Khoapham2004/DOG_ROBOT/README.md

# DOG_ROBOT
First, this project focuses on the research and development of a quadruped robot (Dog Robot). Our team used the mechanical design of the open-source DINGO Quadruped Robot as a reference. The electronic hardware, PCB design, overall kinematics, control algorithms, and software source code were entirely designed and implemented by our team.

This GitHub repository includes the complete project source code, including the Raspberry Pi software, image processing module, robot control commands, firmware for the custom PCB, the software developed to operate the robot, and the complete electrical schematic of the system.







GENERAL 
