Khoapham2004/DOG_ROBOT/PCB_Quadrupped/PCB_Quadrupped.step

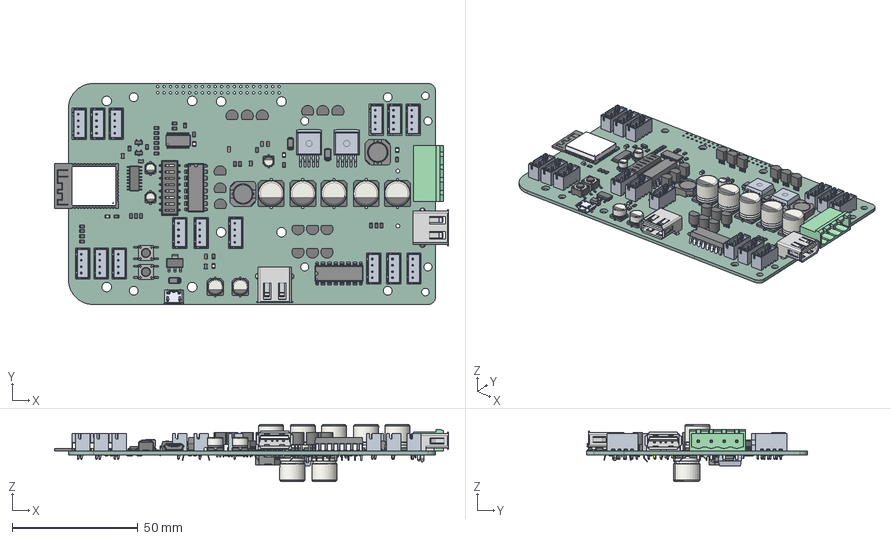
[picture p1: CAD file, 2026-07-23]
PCB_Quadrupped/PCB_Quadrupped.step
156.7 x 88.0 x 22.7 mm
R_0805_2012Metric x 78
CP_Elec_6.3x5.4 x 2
SS54-HF x 4
hoang 1.5 x 15
LED_0805_2012Metric x 6
TO-92_Inline x 15
SOT-23 x 2
C_0805_2012Metric x 8
SW_DIP_SPSTx08_Slide_6.7x21.88mm_W7.62mm_P2.54mm_LowProfile
CP_Elec_10x10.5 x 7
PCA9685PW,118
CP_Elec_4x4.5 x 3
SOIC-16_3.9x9.9mm_P1.27mm
USB-A-S-TH_S x 2
USB-A-S-W-TH_B x 2
USB-A-S-TH_P x 2
SW_Push_1P1T_NO_E-Switch_TL3301NxxxxxG x 2
MCU-MCP3008-I_P_DIP16-7.62MM_ x 2
CDRH104R-100NC--3DModel-STEP-269445 x 3
ESP32-WROOM-32D
SOT-223
ZX62D-B-5P8--3DModel-STEP-56544
PhoenixContact_MSTBA_2,5_4-G-5,08_1x04_P5.08mm_Horizontal
hoang 1.78.1 x 3
hoang_PCB
