Khoapham2004/DOG_ROBOT/(list of files, drawings)

Other design files:
PCB_Quadrupped/freerouting.dsn
