Khoapham2004/DOG_ROBOT/PCB_Quadrupped/PCB_Quadrupped.kicad_pcb

## KiCad design PCB_Quadrupped/PCB_Quadrupped.kicad_pcb (2026-07-23)

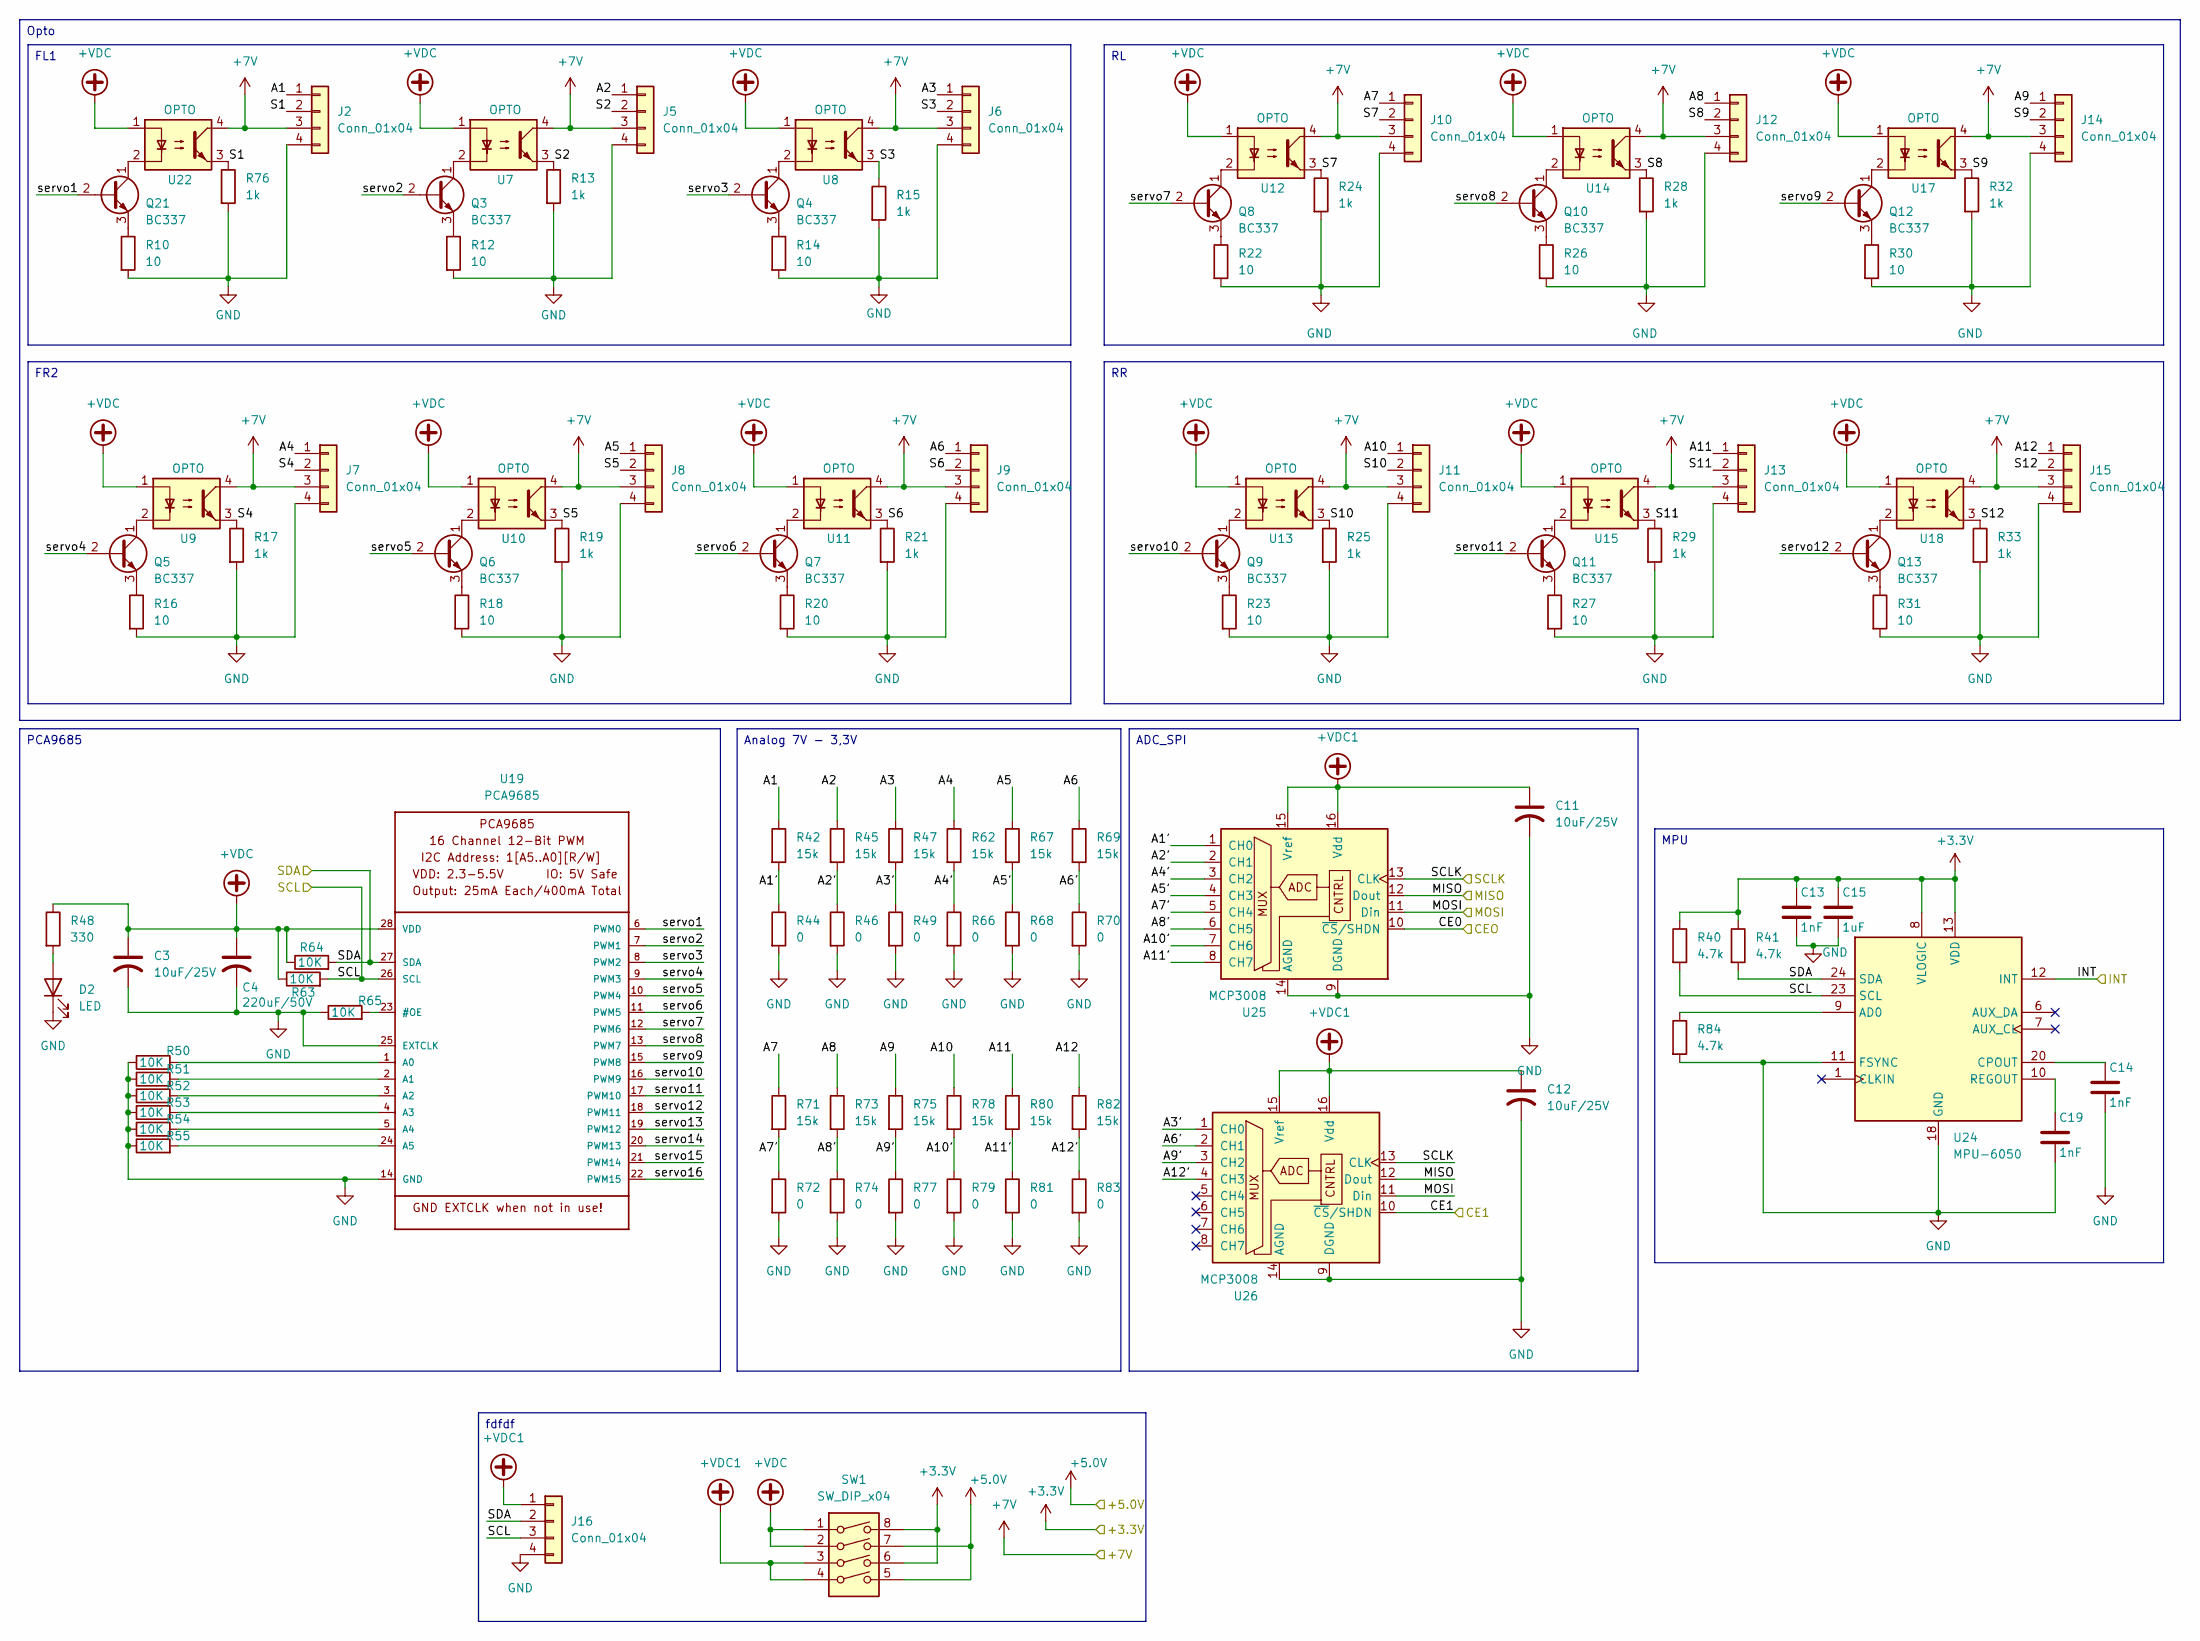
[picture p2: schematic ngoaivi.kicad_sch]

Parts:
C3, C11, C12: 10uF/25V; CP_Elec_4x4.5
C4: 220uF/50V; CP_Elec_10x10.5
C13, C14, C19: 1nF; C_0805_2012Metric
C15: 1uF; C_0805_2012Metric
D2: LED; LED_0805_2012Metric
J2, J5, J6, J7, J8, J9, J10, J11, J12, J13, J14, J15: Conn_01x04; JST_B4B-XH-A_LF__SN_
J16: Conn_01x04; PinHeader_1x04_P2.54mm_Vertical_SMD_Pin1Right
Q3, Q4, Q5, Q6, Q7, Q8, Q9, Q10, Q11, Q12, Q13, Q21: BC337; TO-92_Inline
R10, R12, R14, R16, R18, R20, R22, R23, R26, R27, R30, R31: 10; R_0805_2012Metric_Pad1.20x1.40mm_HandSolder
R13, R15, R17, R19, R21, R24, R25, R28, R29, R32, R33, R76: 1k; R_0805_2012Metric_Pad1.20x1.40mm_HandSolder
R40, R41, R84: 4.7k; R_0805_2012Metric_Pad1.20x1.40mm_HandSolder
R42, R45, R47, R62, R67, R69, R71, R73, R75, R78, R80, R82: 15k; R_0805_2012Metric_Pad1.20x1.40mm_HandSolder
R44, R46, R49, R66, R68, R70, R72, R74, R77, R79, R81, R83: 0; R_0805_2012Metric_Pad1.20x1.40mm_HandSolder
R48: 330; R_0805_2012Metric_Pad1.20x1.40mm_HandSolder
R50, R51, R52, R53, R54, R55, R63, R64, R65: 10K; R_0805_2012Metric_Pad1.20x1.40mm_HandSolder
SW1: SW_DIP_x04; SW_DIP_SPSTx04_Slide_9.78x12.34mm_W7.62mm_P2.54mm
U7, U8, U9, U10, U11, U12, U13, U14, U15, U17, U18, U22: OPTO; OptoIsolation-EL357N-G
U19: PCA9685; TSSOP28
U24: MPU-6050; InvenSense_QFN-24_4x4mm_P0.5mm
U25, U26: MCP3008; DIP16-2.54-19.2X7.62MM

Connections:
+3.3V: C13.1, C15.1, R40.1, R41.1, SW1.6, SW1.8, U24.8 (VLOGIC), U24.13 (VDD); also elsewhere on the board
+5.0V: SW1.5, SW1.7; also elsewhere on the board
+7V: J2.3, J5.3, J6.3, J7.3, J8.3, J9.3, J10.3, J11.3, J12.3, J13.3, J14.3, J15.3, U7.4, U8.4, U9.4, U10.4, U11.4, U12.4, U13.4, U14.4, U15.4, U17.4, U18.4, U22.4; also elsewhere on the board
+VDC: C3.1, C4.1, R48.1, R63.1, R64.1, SW1.1, SW1.2, U7.1, U8.1, U9.1, U10.1, U11.1, U12.1, U13.1, U14.1, U15.1, U17.1, U18.1, U19.28 (VDD), U22.1
+VDC1: C11.1, C12.1, J16.1, SW1.3, SW1.4, U25.15 (Vref), U25.16 (Vdd), U26.15 (Vref), U26.16 (Vdd)
/Ngoại vi/A1: J2.1, R42.1
/Ngoại vi/A1': R42.2, R44.1, U25.1 (CH0)
/Ngoại vi/A2: J5.1, R45.1
/Ngoại vi/A2': R45.2, R46.1, U25.2 (CH1)
/Ngoại vi/A3: J6.1, R47.1
/Ngoại vi/A3': R47.2, R49.1, U26.1 (CH0)
/Ngoại vi/A4: J7.1, R62.1
/Ngoại vi/A4': R62.2, R66.1, U25.3 (CH2)
/Ngoại vi/A5: J8.1, R67.1
/Ngoại vi/A5': R67.2, R68.1, U25.4 (CH3)
/Ngoại vi/A6: J9.1, R69.1
/Ngoại vi/A6': R69.2, R70.1, U26.2 (CH1)
/Ngoại vi/A7: J10.1, R71.1
/Ngoại vi/A7': R71.2, R72.1, U25.5 (CH4)
/Ngoại vi/A8: J12.1, R73.1
/Ngoại vi/A8': R73.2, R74.1, U25.6 (CH5)
/Ngoại vi/A9: J14.1, R75.1
/Ngoại vi/A9': R75.2, R77.1, U26.3 (CH2)
/Ngoại vi/A10: J11.1, R78.1
/Ngoại vi/A10': R78.2, R79.1, U25.7 (CH6)
/Ngoại vi/A11: J13.1, R80.1
/Ngoại vi/A11': R80.2, R81.1, U25.8 (CH7)
/Ngoại vi/A12: J15.1, R82.1
/Ngoại vi/A12': R82.2, R83.1, U26.4 (CH3)
/Ngoại vi/CE0: U25.10 (~CS/SHDN); also elsewhere on the board
/Ngoại vi/CE1: U26.10 (~CS/SHDN); also elsewhere on the board
/Ngoại vi/INT: U24.12 (INT); also elsewhere on the board
/Ngoại vi/MISO: U25.12 (Dout), U26.12 (Dout); also elsewhere on the board
/Ngoại vi/MOSI: U25.11 (Din), U26.11 (Din); also elsewhere on the board
/Ngoại vi/S1: J2.2, R76.1, U22.3
/Ngoại vi/S2: J5.2, R13.1, U7.3
/Ngoại vi/S3: J6.2, R15.1, U8.3
/Ngoại vi/S4: J7.2, R17.1, U9.3
/Ngoại vi/S5: J8.2, R19.1, U10.3
/Ngoại vi/S6: J9.2, R21.1, U11.3
/Ngoại vi/S7: J10.2, R24.1, U12.3
/Ngoại vi/S8: J12.2, R28.1, U14.3
/Ngoại vi/S9: J14.2, R32.1, U17.3
/Ngoại vi/S10: J11.2, R25.1, U13.3
/Ngoại vi/S11: J13.2, R29.1, U15.3
/Ngoại vi/S12: J15.2, R33.1, U18.3
/Ngoại vi/SCL: J16.3, R40.2, R63.2, U19.26 (SCL), U24.23 (SCL); also elsewhere on the board
/Ngoại vi/SCLK: U25.13 (CLK), U26.13 (CLK); also elsewhere on the board
/Ngoại vi/SDA: J16.2, R41.2, R64.2, U19.27 (SDA), U24.24 (SDA); also elsewhere on the board
/Ngoại vi/servo1: Q21.2 (B), U19.6 (PWM0)
/Ngoại vi/servo2: Q3.2 (B), U19.7 (PWM1)
/Ngoại vi/servo3: Q4.2 (B), U19.8 (PWM2)
/Ngoại vi/servo4: Q5.2 (B), U19.9 (PWM3)
/Ngoại vi/servo5: Q6.2 (B), U19.10 (PWM4)
/Ngoại vi/servo6: Q7.2 (B), U19.11 (PWM5)
/Ngoại vi/servo7: Q8.2 (B), U19.12 (PWM6)
/Ngoại vi/servo8: Q10.2 (B), U19.13 (PWM7)
/Ngoại vi/servo9: Q12.2 (B), U19.15 (PWM8)
/Ngoại vi/servo10: Q9.2 (B), U19.16 (PWM9)
/Ngoại vi/servo11: Q11.2 (B), U19.17 (PWM10)
/Ngoại vi/servo12: Q13.2 (B), U19.18 (PWM11)
/Ngoại vi/servo13: U19.19 (PWM12)
/Ngoại vi/servo14: U19.20 (PWM13)
/Ngoại vi/servo15: U19.21 (PWM14)
/Ngoại vi/servo16: U19.22 (PWM15)
GND: C3.2, C4.2, C11.2, C12.2, C13.2, C14.2, C15.2, C19.2, D2.1 (K), J2.4, J5.4, J6.4, J7.4, J8.4, J9.4, J10.4, J11.4, J12.4, J13.4, J14.4, J15.4, J16.4, R10.2, R12.2, R13.2, R14.2, R15.2, R16.2, R17.2, R18.2, R19.2, R20.2, R21.2, R22.2, R23.2, R24.2, R25.2, R26.2, R27.2, R28.2, R29.2, R30.2, R31.2, R32.2, R33.2, R44.2, R46.2, R49.2, R50.1, R51.1, R52.1, R53.1, R54.1, R55.1, R65.1, R66.2, R68.2, R70.2, R72.2, R74.2, R76.2, R77.2, R79.2, R81.2, R83.2, R84.2, U19.14 (GND), U19.25 (EXTCLK), U24.11 (FSYNC), U24.18 (GND), U25.9 (DGND), U25.14 (AGND), U26.9 (DGND), U26.14 (AGND); also elsewhere on the board
unnamed: D2.2 (A), R48.2
unnamed: Q3.1 (C), U7.2
unnamed: Q3.3 (E), R12.1
unnamed: Q4.1 (C), U8.2
unnamed: Q4.3 (E), R14.1
unnamed: Q5.1 (C), U9.2
unnamed: Q5.3 (E), R16.1
unnamed: Q6.1 (C), U10.2
unnamed: Q6.3 (E), R18.1
unnamed: Q7.1 (C), U11.2
unnamed: Q7.3 (E), R20.1
unnamed: Q8.1 (C), U12.2
unnamed: Q8.3 (E), R22.1
unnamed: Q9.1 (C), U13.2
unnamed: Q9.3 (E), R23.1
unnamed: Q10.1 (C), U14.2
unnamed: Q10.3 (E), R26.1
unnamed: Q11.1 (C), U15.2
unnamed: Q11.3 (E), R27.1
unnamed: Q12.1 (C), U17.2
unnamed: Q12.3 (E), R30.1
unnamed: Q13.1 (C), U18.2
unnamed: Q13.3 (E), R31.1
unnamed: Q21.1 (C), U22.2
unnamed: Q21.3 (E), R10.1
unnamed: R65.2, U19.23 (#OE)
unnamed: R50.2, U19.1 (A0)
unnamed: R51.2, U19.2 (A1)
unnamed: R52.2, U19.3 (A2)
unnamed: R53.2, U19.4 (A3)
unnamed: R54.2, U19.5 (A4)
unnamed: R55.2, U19.24 (A5)
unnamed: R84.1, U24.9 (AD0)
unnamed: C14.1, U24.20 (CPOUT)
unnamed: C19.1, U24.10 (REGOUT)

Notes on the sheet:
ADC_SPI
PCA9685
Opto
fdfdf
FR2
MPU
Analog 7V - 3,3V
FL1

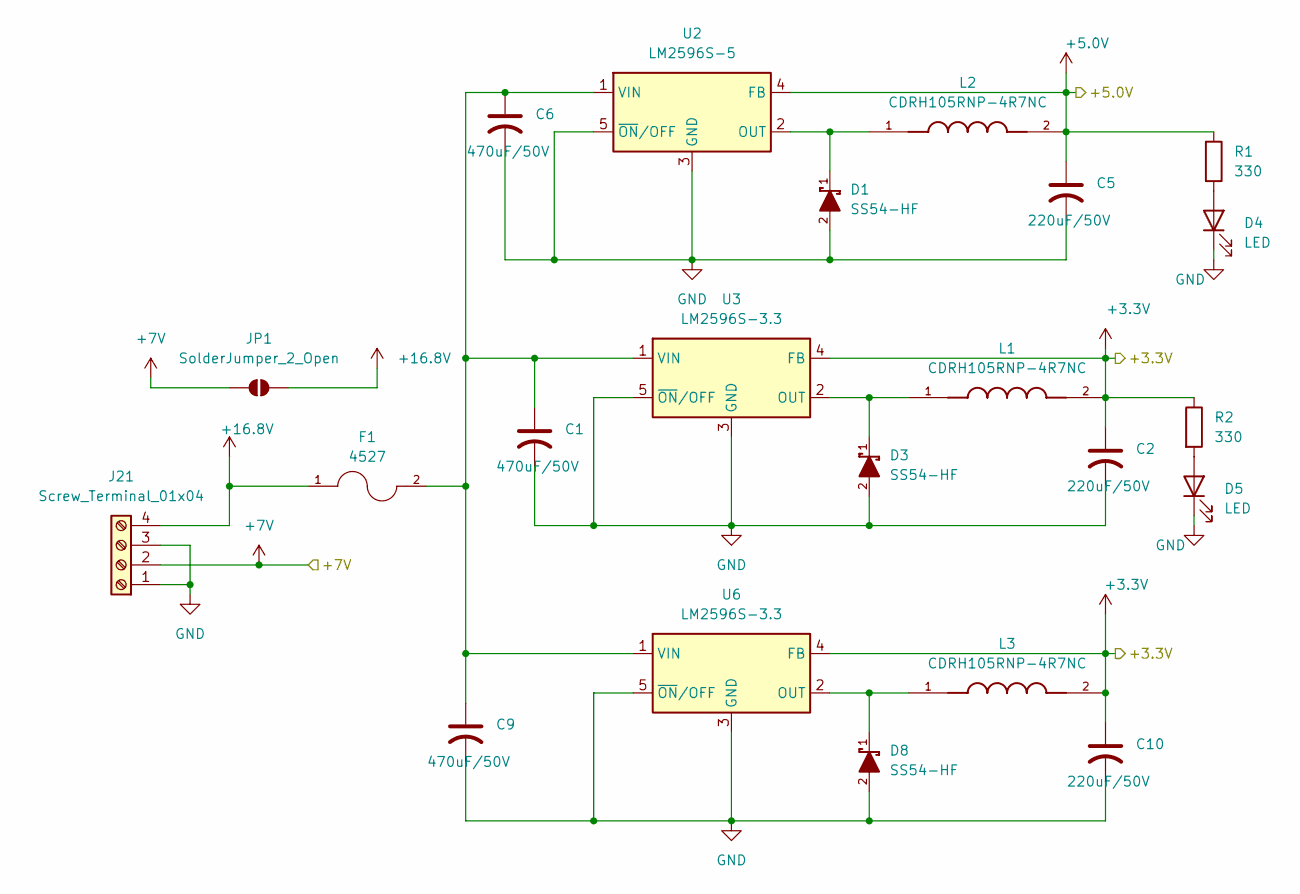
[picture p3: schematic Power.kicad_sch]

Parts:
C1, C6, C9: 470uF/50V; CP_Elec_10x10.5
C2, C5, C10: 220uF/50V; CP_Elec_10x10.5
D1, D3, D8: SS54-HF; DIOM5025X220N; MOUSER_PART_NUMBER 750-SS54-HF
D4, D5: LED; LED_0805_2012Metric
F1: 4527; FUSE_4527
J21: Screw_Terminal_01x04; PhoenixContact_MSTBA_2,5_4-G-5,08_1x04_P5.08mm_Horizontal
JP1: SolderJumper_2_Open; SolderJumper-2_P1.3mm_Open_RoundedPad1.0x1.5mm
L1, L2, L3: CDRH105RNP-4R7NC; IND_CDRH105RNP-4R7NC; PARTREV 23-Oct-2017
R1, R2: 330; R_0805_2012Metric_Pad1.20x1.40mm_HandSolder
U2: LM2596S-5; TO-263-5_TabPin3
U3, U6: LM2596S-3.3; TO-263-5_TabPin3

Connections:
+3.3V: C2.1, C10.1, L1.2, L3.2, R2.1, U3.4 (FB), U6.4 (FB); also elsewhere on the board
+5.0V: C5.1, L2.2, R1.1, U2.4 (FB); also elsewhere on the board
+7V: J21.2, JP1.1 (A); also elsewhere on the board
+16.8V: F1.1, J21.4, JP1.2 (B)
GND: C1.2, C2.2, C5.2, C6.2, C9.2, C10.2, D1.2, D3.2, D4.1 (K), D5.1 (K), D8.2, J21.1, J21.3, U2.3 (GND), U2.5 (~ON/OFF), U3.3 (GND), U3.5 (~ON/OFF), U6.3 (GND), U6.5 (~ON/OFF); also elsewhere on the board
unnamed: D4.2 (A), R1.2
unnamed: D5.2 (A), R2.2
unnamed: D1.1, L2.1, U2.2 (OUT)
unnamed: C1.1, C6.1, C9.1, F1.2, U2.1 (VIN), U3.1 (VIN), U6.1 (VIN)
unnamed: D3.1, L1.1, U3.2 (OUT)
unnamed: D8.1, L3.1, U6.2 (OUT)

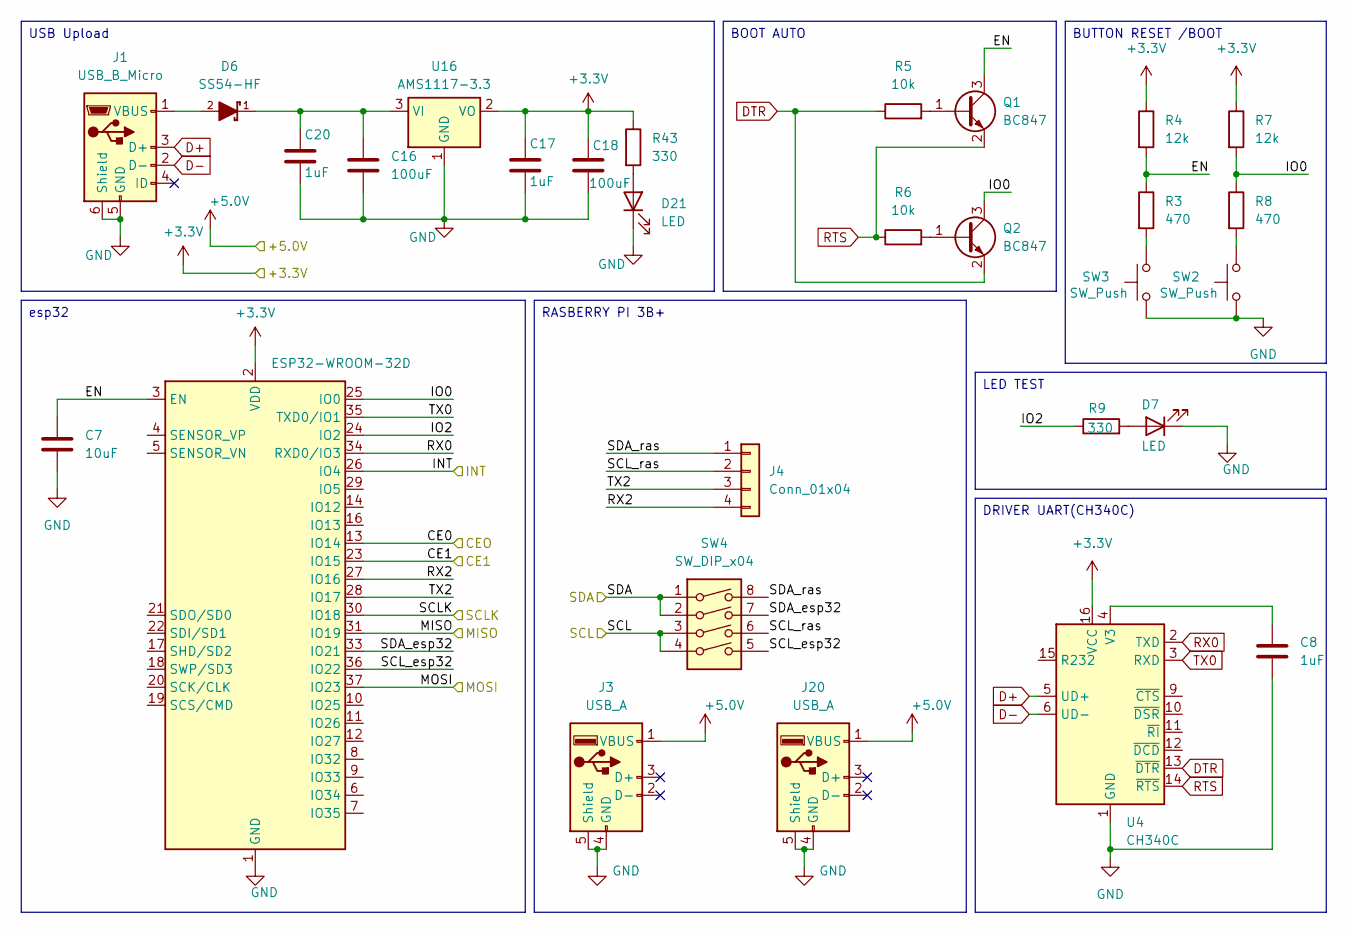
[picture p4: schematic vidieukhien.kicad_sch, Microcontroller]

Parts:
C7: 10uF; C_0805_2012Metric_Pad1.18x1.45mm_HandSolder
C8, C17, C20: 1uF; C_0805_2012Metric_Pad1.18x1.45mm_HandSolder
C16, C18: 100uF; CP_Elec_6.3x5.4
D6: SS54-HF; DIOM5025X220N; MOUSER_PART_NUMBER 750-SS54-HF
D7, D21: LED; LED_0805_2012Metric
J1: USB_B_Micro; USB_Micro-B_Molex-105017-0001
J3: USB_A; USB_A_Stewart_SS-52100-001_Horizontal
J4: Conn_01x04; JST_B4B-XH-A_LF__SN_
J20: USB_A; USB_A_Kycon_KUSBX-AS1N-B_Horizontal
Q1, Q2: BC847; SOT-23
R3, R8: 470; R_0805_2012Metric_Pad1.20x1.40mm_HandSolder
R4, R7: 12k; R_0805_2012Metric_Pad1.20x1.40mm_HandSolder
R5, R6: 10k; R_0805_2012Metric_Pad1.20x1.40mm_HandSolder
R9, R43: 330; R_0805_2012Metric_Pad1.20x1.40mm_HandSolder
SW2, SW3: SW_Push; SW_Push_1P1T_NO_E-Switch_TL3301NxxxxxG
SW4: SW_DIP_x04; SW_DIP_SPSTx04_Slide_9.78x12.34mm_W7.62mm_P2.54mm
U1: ESP32-WROOM-32D
U4: CH340C; SOIC-16_3.9x9.9mm_P1.27mm
U16: AMS1117-3.3; SOT-223-3_TabPin2

Connections:
+3.3V: C17.1, C18.1, R4.1, R7.1, R43.1, U1.2 (VDD), U4.16 (VCC), U16.2 (VO); also elsewhere on the board
+5.0V: J3.1 (VBUS), J20.1 (VBUS); also elsewhere on the board
/Ngoại vi/CE0: U1.13 (IO14); also elsewhere on the board
/Ngoại vi/CE1: U1.23 (IO15); also elsewhere on the board
/Ngoại vi/INT: U1.26 (IO4); also elsewhere on the board
/Ngoại vi/MISO: U1.31 (IO19); also elsewhere on the board
/Ngoại vi/MOSI: U1.37 (IO23); also elsewhere on the board
/Ngoại vi/SCL: SW4.3, SW4.4; also elsewhere on the board
/Ngoại vi/SCLK: U1.30 (IO18); also elsewhere on the board
/Ngoại vi/SDA: SW4.1, SW4.2; also elsewhere on the board
/microcontroler/EN: C7.1, Q1.3 (C), R3.1, R4.2, U1.3 (EN)
/microcontroler/IO0: Q2.3 (C), R7.2, R8.1, U1.25 (IO0)
/microcontroler/IO2: R9.1, U1.24 (IO2)
/microcontroler/RX2: J4.4, U1.27 (IO16)
/microcontroler/SCL_esp32: SW4.5, U1.36 (IO22)
/microcontroler/SCL_ras: J4.2, SW4.6
/microcontroler/SDA_esp32: SW4.7, U1.33 (IO21)
/microcontroler/SDA_ras: J4.1, SW4.8
/microcontroler/TX2: J4.3, U1.28 (IO17)
D+: J1.3 (D+), U4.5 (UD+)
D-: J1.2 (D-), U4.6 (UD-)
DTR: Q2.2 (E), R5.1, U4.13 (~DTR)
GND: C7.2, C8.2, C16.2, C17.2, C18.2, C20.2, D7.1 (K), D21.1 (K), J1.5 (GND), J1.6 (Shield), J3.4 (GND), J3.5 (Shield), J20.4 (GND), J20.5 (Shield), SW2.1, SW3.1, U1.1 (GND), U1.15 (GND), U1.38 (GND), U1.39 (GND), U4.1 (GND), U16.1 (GND); also elsewhere on the board
unnamed: D7.2 (A), R9.2
unnamed: D21.2 (A), R43.2
unnamed: D6.2, J1.1 (VBUS)
unnamed: Q1.1 (B), R5.2
unnamed: Q2.1 (B), R6.2
unnamed: R3.2, SW3.2
unnamed: R8.2, SW2.2
unnamed: C8.1, U4.4 (V3)
unnamed: C16.1, C20.1, D6.1, U16.3 (VI)
RTS: Q1.2 (E), R6.1, U4.14 (~RTS)
RX0: U1.34 (RXD0/IO3), U4.2 (TXD)
TX0: U1.35 (TXD0/IO1), U4.3 (RXD)

Notes on the sheet:
BUTTON RESET /BOOT
DRIVER UART(CH340C)
esp32
RASBERRY PI 3B+
LED TEST
USB Upload
BOOT AUTO

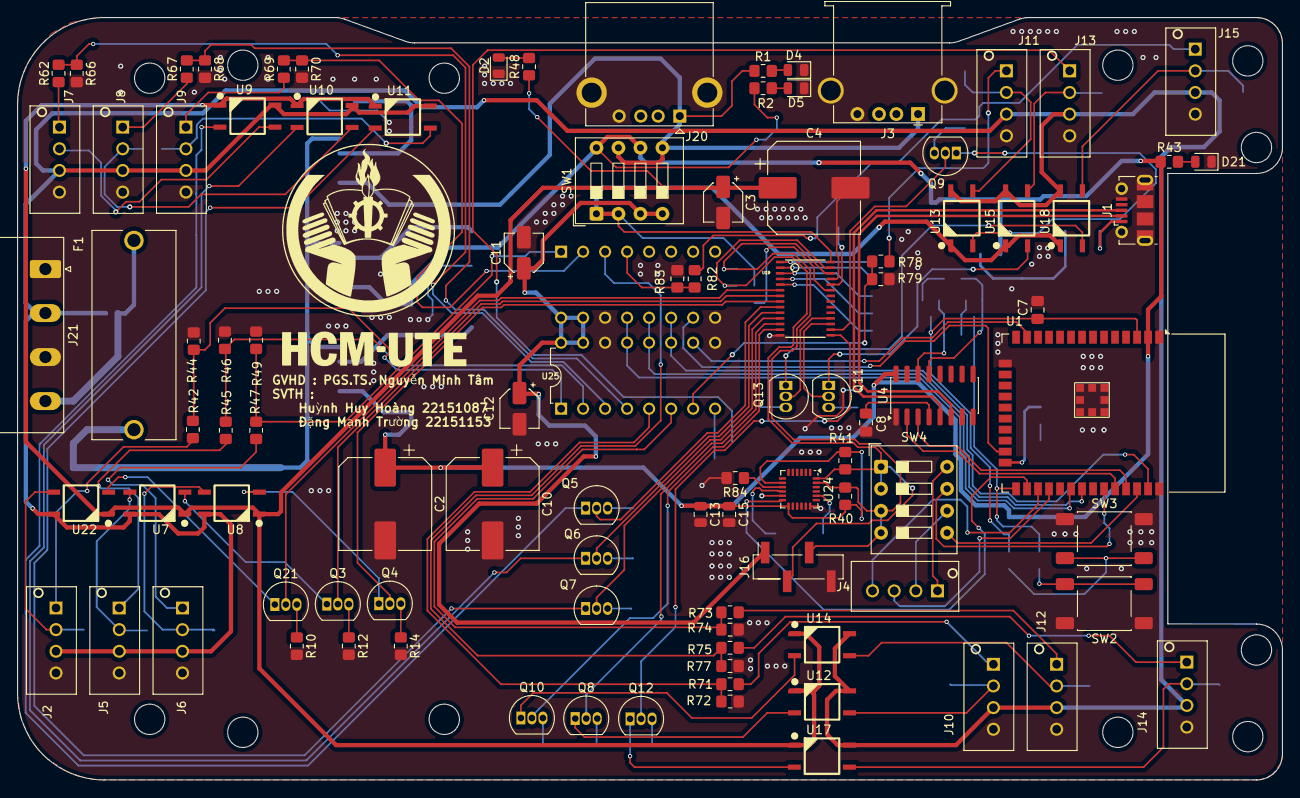
[picture p5: board PCB_Quadrupped.kicad_pcb from above]

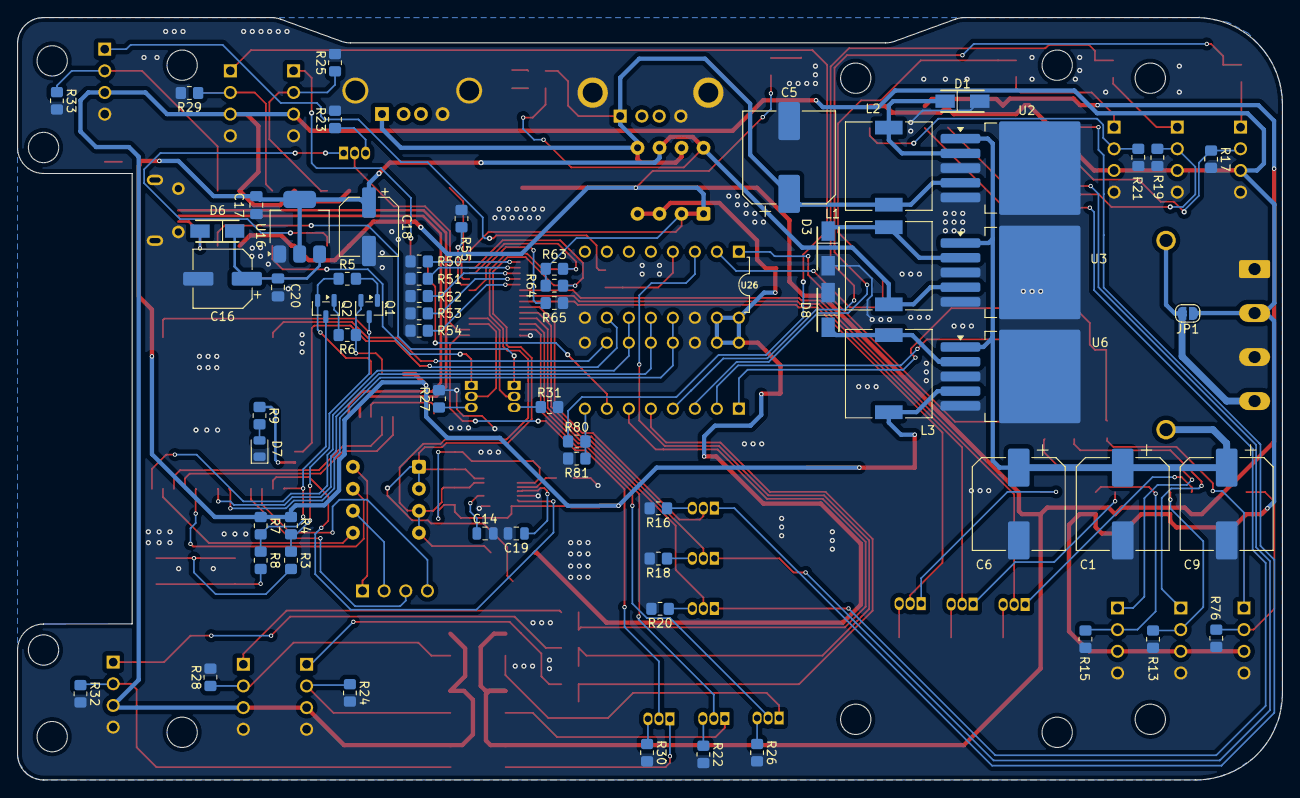
[picture p6: board PCB_Quadrupped.kicad_pcb from below]

Board: 2 copper layers, 146.0 x 88.0 mm, 163 parts (65 on the bottom side), 128 nets.
