Khoapham2004/DOG_ROBOT/CODE/GUI.py

#!/usr/bin/env python3

import time
import socket
import struct
import threading
import json
import os
import math
import csv
from datetime import datetime
from collections import deque
from typing import List, Optional, Tuple

import tkinter as tk
from tkinter import ttk, messagebox, filedialog

import cv2
import numpy as np

from PIL import Image, ImageTk

import matplotlib
matplotlib.use("TkAgg")
from matplotlib.backends.backend_tkagg import FigureCanvasTkAgg
from matplotlib.figure import Figure

import mediapipe as mp

# ============================================================
# Thứ tự gửi setpoint SBAL
# ============================================================
# Quy ước joystick: ngang trái/phải điều chỉnh Roll, dọc lên/xuống điều chỉnh Pitch.
# ESP đang nhận lệnh SET_SBAL_SP theo thứ tự Pitch trước, Roll sau,
# vì vậy GUI gửi theo thứ tự PITCH_ROLL để trục dọc điều khiển đúng Pitch.
SBAL_SP_SEND_ORDER = "PITCH_ROLL"

# ============================================================
# ROS 2 tùy chọn - publish góc khớp sang Gazebo
# ============================================================
ROS_OK = False
ROS_ERR = ""
try:
    import rclpy
    from rclpy.node import Node
    from rclpy.qos import QoSProfile, ReliabilityPolicy, HistoryPolicy
    from trajectory_msgs.msg import JointTrajectory, JointTrajectoryPoint
    from sensor_msgs.msg import Imu
    from builtin_interfaces.msg import Duration
    ROS_OK = True
except Exception as e:
    ROS_ERR = str(e)
    rclpy = None
    Node = object
    Imu = object


# ============================================================
# Camera từ Raspberry
# ============================================================
UDP_IP = "0.0.0.0"
CAMERA_UDP_PORT = 5005

# ============================================================
# Offset từ GUI gửi về Raspberry
# ============================================================
RASPBERRY_IP = "192.168.0.107"
RASPBERRY_OFFSET_PORT = 6006

# ============================================================
# Điều chỉnh chiều cao: GUI gửi trực tiếp X+ / X- xuống ESP thông qua Raspberry.
# ESP bản mới xử lý X+ / X- để thay đổi trục X cho các pose/gait FWD, BWD, LEFT, RIGHT, STOP, SL và SR.
# ============================================================
HEIGHT_DEFAULT_X = -190.0
HEIGHT_STEP_X = 10.0
HEIGHT_MIN_X = -230.0
HEIGHT_MAX_X = -150.0

# ============================================================
# Thông số gait mặc định
# GUI gửi thông số xuống ESP qua Raspberry bằng lệnh:
#   SET_GAIT MODE hStep tCycle phase swingRatio
# Ý nghĩa tham số trong ESP:
#   hStep      : độ nhấc chân theo trục X trong pha vung.
#   tCycle     : thời gian hoàn thành một chu kỳ bước, đơn vị giây.
#   phase      : độ lệch pha giữa hai nhóm chân FL+RR và FR+RL, trong khoảng 0..1.
#   swingRatio : tỉ lệ thời gian chân ở pha vung, trong khoảng 0.05..0.49.
# ============================================================
GAIT_CONFIG_PATH = os.path.expanduser("~/.quadruped_gait_config.json")
GAIT_MODES = ["FWD", "BWD", "LEFT", "RIGHT", "SL", "SR"]
GAIT_DEFAULTS = {
    "FWD":   {"hStep": 100.0, "tCycle": 0.70, "phase": 0.50, "swing": 0.35},
    "BWD":   {"hStep": 100.0, "tCycle": 0.70, "phase": 0.50, "swing": 0.35},
    "LEFT":  {"hStep":  50.0, "tCycle": 0.40, "phase": 0.50, "swing": 0.35},
    "RIGHT": {"hStep":  50.0, "tCycle": 0.40, "phase": 0.50, "swing": 0.35},
    "SL":    {"hStep":  50.0, "tCycle": 0.70, "phase": 0.50, "swing": 0.35},
    "SR":    {"hStep":  50.0, "tCycle": 0.70, "phase": 0.50, "swing": 0.35},
}

# ============================================================
# Tọa độ pose mặc định - đồng bộ với pose trong code ESP.
# Mỗi pose gồm tọa độ của bốn chân: FL(x,y,z), FR(x,y,z), RL(x,y,z), RR(x,y,z).
# ============================================================
POSE_LEGS = ["FL", "FR", "RL", "RR"]
POSE_AXES = ["x", "y", "z"]
POSE_DEFAULTS = {
    "STAND": {"FL": [-190.0, -44.2, 30.0], "FR": [-190.0, 44.2, 40.0], "RL": [-190.0, -44.2, 40.0], "RR": [-190.0, 44.2, 40.0]},
    "SIT":   {"FL": [-230.0, -50.0, 40.0], "FR": [-230.0, 50.0, 40.0], "RL": [-120.0, -100.0, -10.0], "RR": [-120.0, 100.0, -10.0]},
    "LIE":   {"FL": [-80.0, -100.0, -10.0], "FR": [-80.0, 100.0, -10.0], "RL": [-80.0, -100.0, -10.0], "RR": [-80.0, 100.0, -10.0]},
    "SHAKE": {"FL": [-225.0, -55.0, 35.0], "FR": [-230.0, 0.0, 40.0], "RL": [-120.0, -100.0, -10.0], "RR": [-120.0, 100.0, -10.0]},
    "STAMP": {"FL": [-210.0, -55.0, 0.0], "FR": [-210.0, 55.0, 0.0], "RL": [-210.0, -55.0, 20.0], "RR": [-210.0, 55.0, 20.0]},
    "FWD":   {"FL": [-197.0, -55.0, 0.0], "FR": [-210.0, 55.0, 0.0], "RL": [-197.0, -55.0, 20.0], "RR": [-210.0, 55.0, 20.0]},
    "BWD":   {"FL": [-201.0, -55.0, 0.0], "FR": [-210.0, 55.0, 0.0], "RL": [-201.0, -55.0, 20.0], "RR": [-210.0, 55.0, 20.0]},
    "LEFT":  {"FL": [-210.0, 0.0, 0.0], "FR": [-210.0, 100.0, 0.0], "RL": [-210.0, 0.0, 20.0], "RR": [-210.0, 100.0, 20.0]},
    "RIGHT": {"FL": [-210.0, -100.0, 0.0], "FR": [-210.0, 0.0, 0.0], "RL": [-210.0, -100.0, 20.0], "RR": [-210.0, 0.0, 20.0]},
    "SIDE":  {"FL": [-202.0, -55.0, 0.0], "FR": [-210.0, 55.0, 0.0], "RL": [-202.0, -55.0, 20.0], "RR": [-210.0, 55.0, 20.0]},
}
POSE_CONFIG_PATH = os.path.expanduser("~/.quadruped_pose_coords.json")

# ============================================================
# GUI nhận dữ liệu IMU từ Raspberry
# ============================================================
IMU_LISTEN_IP = "0.0.0.0"
IMU_LISTEN_PORT = 7007

# ============================================================
# Camera và MediaPipe
# ============================================================
WIDTH = 640
HEIGHT = 480

GAUSS_KERNEL = (5, 5)
GAUSS_SIGMA = 0

CENTER_DEADBAND_PX = 25

MIN_DETECTION_CONF = 0.5
MIN_TRACKING_CONF = 0.5
FULL_BODY_VISIBILITY_TH = 0.45

SEND_INTERVAL = 0.05
LPF_ALPHA = 0.85

BOX_H_LIMIT = 360

# ============================================================
# Giảm offset theo bề rộng khung người
# ============================================================
# Khi box_width_lpf <= OFFSET_SCALE_REF_BOX_W, offset gửi xuống bridge được giữ nguyên.
# Khi box_width_lpf lớn hơn giá trị tham chiếu, offset_send = offset_lpf * (REF / box_width_lpf).
# OFFSET_SCALE_MIN_RATIO giới hạn mức giảm nhỏ nhất để offset không bị thu nhỏ về 0.
# Ví dụ với REF=260, box_width_lpf=520 và min_ratio=0.25:
#   scale = max(260/520, 0.25) = 0.50, nghĩa là offset gửi đi còn 50%.
OFFSET_SCALE_BY_BOX_W_ENABLE = 1
OFFSET_SCALE_REF_BOX_W = 260
OFFSET_SCALE_MIN_RATIO = 0.25

# Lệnh từ GUI gửi về Pi, sau đó Pi chuyển tiếp xuống ESP.
AUTO_STAND_BEFORE_FWD = False

SEND_PID_SETTING_ON_START = False
CAM_PID_CMD = "SET_CAMGAIT 0.18 0.00 0.04 35 25 6 120"

SEND_STOP_SETTING_ON_START = False
CAM_STOP_CMD = "SET_CAMSTOP 360 800"

# ============================================================
# Cấu hình đồ thị
# ============================================================
PLOT_SECONDS_WINDOW = 5
PLOT_MAX_POINTS = 400

ROLL_YLIM = (-20, 20)
PITCH_YLIM = (-20, 20)
YAW_YLIM = (-180, 180)

# ============================================================
# Làm mượt đồ thị Balance theo thời gian thực
# ============================================================
# Các thông số này chỉ dùng cho đường vẽ live ở tab Balance, giúp hạn chế giật do spike hoặc rung UDP.
# Dữ liệu ghi vào file CSV vẫn là dữ liệu raw, không bị lọc.
BALANCE_PLOT_FILTER_ENABLE = 0       # Không lọc ở GUI. ESP đã lọc rồi, GUI chỉ vẽ raw mới nhất.
BALANCE_PLOT_LPF_ALPHA = 0.0         # Giữ lại để tương thích file config cũ, không dùng cho Balance plot.
BALANCE_PLOT_MAX_STEP_DEG = 999.0    # Giữ lại để tương thích file config cũ, không dùng cho Balance plot.
BALANCE_PLOT_FIXED_Y = 1             # 1 = giữ trục Y cố định -20..20 để hình không bị giật do autoscale.
BALANCE_PLOT_UPDATE_MS = 30          # Chu kỳ vẽ Balance. 30 ms tương đương khoảng 33 Hz.

# Giới hạn kích thước hiển thị camera để khung giao diện gọn hơn.
CAMERA_DISPLAY_MAX_W = 760
CAMERA_DISPLAY_MAX_H = 570

# ============================================================
# Thông tin hiển thị trên GUI
# ============================================================
UNIVERSITY_NAME = "TRƯỜNG ĐẠI HỌC CÔNG NGHỆ KỸ THUẬT TP.HCM"
PROJECT_TITLE = "ĐỀ TÀI: THIẾT KẾ, CHẾ TẠO VÀ ĐIỀU KHIỂN ROBOT 4 CHÂN"
SUPERVISOR_NAME = "GVHD: PGS.TS NGUYỄN MINH TÂM"
STUDENT_NAMES = "SVTH: ĐẶNG MẠNH TRƯỜNG - HUỲNH HUY HOÀNG"

LEFT_LOGO_FILES = [
    "logo FEEE.jpg", "logo FEEE.jpeg", "logo FEEE.png",
    "logo FEEE.JPG", "logo FEEE.JPEG", "logo FEEE.PNG"
]
RIGHT_LOGO_FILES = [
    "LOGO UTE.png", "LOGO UTE.PNG", "LOGO UTE.jpg", "LOGO UTE.jpeg",
    "HCMUTE.png", "hcmute.png"
]
UTE_LOGO_TARGET_HEIGHT = 110
FEEE_LOGO_HEIGHT_RATIO = 0.8
LOGO_TEXT_GAP_X = 28

# ============================================================
# Lưu và tải cấu hình
# ============================================================
CONFIG_PATH = os.path.expanduser("~/.cam_udp_pose_gui_config.json")
REC_DEFAULT_DIR = os.path.expanduser("~/Desktop")

MODEL_COMPLEXITY = 0
CAMERA_DISPLAY_SCALE = 0.96
PLOT_UPDATE_MS = 80

# ============================================================
# Tinh chỉnh hiệu năng và FPS, có thể thay đổi trong tab Cài đặt thông số.
# ============================================================
# 1 = xử lý MediaPipe ở mọi frame; 2/3/4 = xử lý cách frame để GUI nhẹ và mượt hơn.
CAM_PROCESS_EVERY_N = 3
# 1 = chỉ chạy MediaPipe khi bật chế độ bám người; 0 = luôn chạy MediaPipe.
CAM_MEDIAPIPE_ONLY_WHEN_PID = 1
# 1 = vẽ skeleton MediaPipe; 0 = không vẽ skeleton để giảm tải CPU.
CAM_DRAW_LANDMARKS = 0
# Chu kỳ gọi update_frame của Tkinter, đơn vị ms; giá trị nhỏ giúp mượt hơn nhưng tốn CPU hơn.
CAM_UPDATE_MS = 10
# 1 = bật publish JointTrajectory sang Gazebo; 0 = tắt mặc định để GUI nhẹ hơn.
GAZEBO_PUBLISH_ENABLE = 0

# ============================================================
# Chế độ ưu tiên Balance
# Khi chuyển sang tab Balance, GUI sẽ tạm dừng các tác vụ nặng
# như decode/hiển thị camera, publish Gazebo và vẽ plot Gazebo để giảm lag.
# Luồng IMU UDP và chức năng ghi CSV vẫn hoạt động bình thường.
# ============================================================
BALANCE_FOCUS_MODE_ENABLE = 1
BALANCE_PAUSE_CAMERA = 1
BALANCE_PAUSE_GAZEBO_PUBLISH = 1
BALANCE_PAUSE_GAZEBO_IMU_PLOT = 1
BALANCE_PAUSE_JOINT_TABLE_UI = 1


# ============================================================
# Cấu hình nhận Joint UDP và mapping sang Gazebo
# ============================================================
JOINT_UDP_LISTEN_IP = "0.0.0.0"
JOINT_UDP_LISTEN_PORT = 6001
JOINT_CONFIG_PATH = os.path.expanduser("~/.quadruped_gazebo_joint_mapper.json")
JOINT_DEFAULT_TOPIC = "/joint_trajectory_controller/joint_trajectory"
JOINT_PUBLISH_HZ_LIMIT = 10.0
JOINT_POINT_TIME_SEC = 0.02
JOINT_UI_UPDATE_MS = 50

# Topic IMU của Gazebo dùng để so sánh với IMU thực tế nhận từ Raspberry qua UDP 7007.
GAZEBO_IMU_TOPIC = "/imu"
GAZEBO_IMU_PLOT_MAX_POINTS = 500
GAZEBO_IMU_PLOT_WINDOW_SEC = 10.0
GAZEBO_IMU_PLOT_UPDATE_MS = 80


RAW_JOINT_ORDER = [
    "FL_j1", "FL_j2", "FL_j3",
    "FR_j1", "FR_j2", "FR_j3",
    "RL_j1", "RL_j2", "RL_j3",
    "RR_j1", "RR_j2", "RR_j3",
]

# Thứ tự publish được giữ giống cấu hình controller trong Gazebo:
# JFL -> JFR -> JBL -> JBR
GAZEBO_PUBLISH_ORDER = [
    "JFL1", "JFL2", "JFL3",
    "JFR1", "JFR2", "JFR3",
    "JBL1", "JBL2", "JBL3",
    "JBR1", "JBR2", "JBR3",
]

# Dữ liệu đầu vào là góc IK raw sau tính toán động học nghịch, không phải góc servo đã quy đổi.
# Các joint thật trong Gazebo gồm: JBL1..3, JBR1..3, JFL1..3 và JFR1..3.
# ESP/Raspberry gửi dữ liệu theo thứ tự FL, FR, RL, RR nên cần mapping như dưới.
# FL -> JFL, FR -> JFR, RL -> JBL, RR -> JBR.
DEFAULT_JOINT_MAPPING = [
    {"src": "FL_j1", "joint": "JFL1", "sign":  1.0, "offset_deg": 0.0, "enable": True},
    {"src": "FL_j2", "joint": "JFL2", "sign":  1.0, "offset_deg": 0.0, "enable": True},
    {"src": "FL_j3", "joint": "JFL3", "sign":  1.0, "offset_deg": 0.0, "enable": True},
    {"src": "FR_j1", "joint": "JFR1", "sign":  1.0, "offset_deg": 0.0, "enable": True},
    {"src": "FR_j2", "joint": "JFR2", "sign":  1.0, "offset_deg": 0.0, "enable": True},
    {"src": "FR_j3", "joint": "JFR3", "sign":  1.0, "offset_deg": 0.0, "enable": True},
    {"src": "RL_j1", "joint": "JBL1", "sign":  1.0, "offset_deg": 0.0, "enable": True},
    {"src": "RL_j2", "joint": "JBL2", "sign":  1.0, "offset_deg": 0.0, "enable": True},
    {"src": "RL_j3", "joint": "JBL3", "sign":  1.0, "offset_deg": 0.0, "enable": True},
    {"src": "RR_j1", "joint": "JBR1", "sign":  1.0, "offset_deg": 0.0, "enable": True},
    {"src": "RR_j2", "joint": "JBR2", "sign":  1.0, "offset_deg": 0.0, "enable": True},
    {"src": "RR_j3", "joint": "JBR3", "sign":  1.0, "offset_deg": 0.0, "enable": True},
]

mp_pose = mp.solutions.pose
mp_drawing = mp.solutions.drawing_utils
mp_styles = mp.solutions.drawing_styles


class UdpCameraReceiver:
    def __init__(self, ip="0.0.0.0", port=5005):
        self.ip = ip
        self.port = port

        self.sock = None
        self.running = False
        self.thread = None

        self.frames = {}
        self.latest_frame = None
        self.lock = threading.Lock()

        self.last_packet_time = 0.0
        self.recv_fps = 0.0
        self._fps_count = 0
        self._fps_last_time = time.time()

        # Khi vào tab Balance, có thể tạm dừng decode JPEG để giảm tải CPU.
        # Socket vẫn được đọc để tránh đầy buffer, nhưng frame sẽ được bỏ qua.
        self.paused = False

    def start(self):
        self.sock = socket.socket(socket.AF_INET, socket.SOCK_DGRAM)
        self.sock.bind((self.ip, self.port))
        self.sock.settimeout(0.1)

        self.running = True
        self.thread = threading.Thread(target=self._recv_loop, daemon=True)
        self.thread.start()

        print(f"[UDP CAM] Dang nhan camera tai {self.ip}:{self.port}")

    def stop(self):
        self.running = False
        try:
            if self.sock:
                self.sock.close()
        except Exception:
            pass

    def set_paused(self, paused: bool):
        self.paused = bool(paused)
        if self.paused:
            # Xóa các chunk/frame cũ để khi bật lại không hiển thị frame tồn đọng.
            with self.lock:
                self.frames.clear()
                self.latest_frame = None
            self.recv_fps = 0.0
            self._fps_count = 0
            self._fps_last_time = time.time()

    def get_frame(self):
        with self.lock:
            if self.latest_frame is None:
                return None
            return self.latest_frame.copy()

    def _recv_loop(self):
        while self.running:
            try:
                packet, addr = self.sock.recvfrom(65536)
            except socket.timeout:
                continue
            except OSError:
                break
            except Exception as e:
                print("[UDP CAM ERR]", e)
                continue

            if self.paused:
                # Ở chế độ ưu tiên Balance, camera được bỏ qua ngay từ mức gói UDP,
                # nhờ đó tránh ghép chunk và decode JPEG gây lag GUI.
                continue

            if len(packet) < 8:
                continue

            header = packet[:8]
            chunk = packet[8:]

            try:
                frame_id, total_chunks, chunk_id = struct.unpack("!IHH", header)
            except Exception:
                continue

            if frame_id not in self.frames:
                self.frames[frame_id] = {
                    "total": total_chunks,
                    "chunks": {}
                }

            self.frames[frame_id]["chunks"][chunk_id] = chunk

            if len(self.frames[frame_id]["chunks"]) == total_chunks:
                try:
                    data = b"".join(
                        self.frames[frame_id]["chunks"][i]
                        for i in range(total_chunks)
                    )
                except KeyError:
                    self.frames.pop(frame_id, None)
                    continue

                self.frames.pop(frame_id, None)

                jpg_array = np.frombuffer(data, dtype=np.uint8)
                frame = cv2.imdecode(jpg_array, cv2.IMREAD_COLOR)

                if frame is None:
                    continue

                with self.lock:
                    self.latest_frame = frame

                self.last_packet_time = time.time()

                self._fps_count += 1
                now = time.time()
                if now - self._fps_last_time >= 1.0:
                    self.recv_fps = self._fps_count / (now - self._fps_last_time)
                    self._fps_count = 0
                    self._fps_last_time = now

                if len(self.frames) > 40:
                    old_keys = sorted(self.frames.keys())[:-10]
                    for k in old_keys:
                        self.frames.pop(k, None)


class UdpImuReceiver:
    def __init__(self, ip="0.0.0.0", port=7007):
        self.ip = ip
        self.port = port

        self.sock = None
        self.running = False
        self.thread = None

        self.lock = threading.Lock()

        self.roll = 0.0
        self.pitch = 0.0
        self.yaw = 0.0

        self.last_packet_time = 0.0
        self.recv_count = 0
        self.recv_hz = 0.0
        self._count_t0 = time.time()
        self._count_n = 0
        self.sample_seq = 0
        self.sample_buffer = deque(maxlen=10000)  # lưu tất cả mẫu UDP nhận được để REC không bị giới hạn bởi GUI update

    def start(self):
        self.sock = socket.socket(socket.AF_INET, socket.SOCK_DGRAM)
        self.sock.bind((self.ip, self.port))
        self.sock.settimeout(0.1)

        self.running = True
        self.thread = threading.Thread(target=self._recv_loop, daemon=True)
        self.thread.start()

        print(f"[UDP IMU] Dang nhan IMU tai {self.ip}:{self.port}")

    def stop(self):
        self.running = False

        try:
            if self.sock:
                self.sock.close()
        except Exception:
            pass

    def get_imu(self):
        with self.lock:
            return self.roll, self.pitch, self.yaw, self.last_packet_time

    def get_recv_hz(self):
        # Tần số thực tế GUI nhận gói IMU từ Raspberry/ESP, tính trong cửa sổ khoảng 1 giây.
        with self.lock:
            return self.recv_hz

    def get_latest_sample(self):
        # Dùng cho live plot: lấy đúng mẫu mới nhất, không lọc và không vẽ dồn buffer.
        with self.lock:
            return (
                self.sample_seq,
                self.last_packet_time,
                self.roll,
                self.pitch,
                self.yaw,
                self.recv_hz,
            )

    def get_latest_seq(self):
        with self.lock:
            return self.sample_seq

    def get_samples_since(self, last_seq):
        # Trả về toàn bộ mẫu mới GUI nhận từ Raspberry, không phụ thuộc tốc độ cập nhật giao diện.
        with self.lock:
            samples = [s for s in self.sample_buffer if s[0] > last_seq]
            latest_seq = self.sample_seq
        return samples, latest_seq

    def _recv_loop(self):
        while self.running:
            try:
                packet, addr = self.sock.recvfrom(1024)
            except socket.timeout:
                continue
            except OSError:
                break
            except Exception as e:
                print("[UDP IMU ERR]", e)
                continue

            msg = packet.decode("utf-8", errors="ignore").strip()
            parts = msg.split(",")

            if len(parts) < 3:
                continue

            try:
                roll = float(parts[0])
                pitch = float(parts[1])
                yaw = float(parts[2])
            except Exception:
                continue

            now = time.time()
            with self.lock:
                self.roll = roll
                self.pitch = pitch
                self.yaw = yaw
                self.last_packet_time = now
                self.recv_count += 1
                self._count_n += 1
                dt = now - self._count_t0
                if dt >= 1.0:
                    self.recv_hz = self._count_n / dt
                    self._count_n = 0
                    self._count_t0 = now
                self.sample_seq += 1
                self.sample_buffer.append((self.sample_seq, now, roll, pitch, yaw))


# ============================================================
# Panel mapping góc khớp sang Gazebo
# ============================================================
class GazeboJointPublisher(Node):
    def __init__(self, topic: str):
        super().__init__("quadruped_joint_mapper_gui")
        self.topic = topic

        # Controller đang subscribe ở chế độ BEST_EFFORT, nên publisher cũng dùng BEST_EFFORT để tương thích.
        try:
            qos = QoSProfile(
                history=HistoryPolicy.KEEP_LAST,
                depth=10,
                reliability=ReliabilityPolicy.BEST_EFFORT,
            )
            self.pub = self.create_publisher(JointTrajectory, topic, qos)
        except Exception:
            self.pub = self.create_publisher(JointTrajectory, topic, 10)

    def publish_positions(self, joint_names: List[str], positions_rad: List[float], point_time_sec: float):
        # Format publish giống cấu hình mẫu của Gazebo:
        # msg.joint_names = ['JFL1','JFL2','JFL3','JFR1','JFR2','JFR3','JBL1','JBL2','JBL3','JBR1','JBR2','JBR3']
        # point.positions dùng đơn vị radian và cùng thứ tự với danh sách joint.
        msg = JointTrajectory()
        msg.joint_names = list(joint_names)

        p = JointTrajectoryPoint()
        p.positions = [float(x) for x in positions_rad]
        sec = int(point_time_sec)
        p.time_from_start = Duration(
            sec=sec,
            nanosec=int((point_time_sec - sec) * 1e9),
        )
        msg.points.append(p)
        self.pub.publish(msg)


class UdpJointReceiver:
    def __init__(self, ip: str, port: int):
        self.ip = ip
        self.port = port
        self.sock = None
        self.running = False
        self.thread = None
        self.lock = threading.Lock()
        self.latest_deg = [0.0] * 12
        self.latest_order = list(RAW_JOINT_ORDER)
        self.seq = 0
        self.last_packet_time = 0.0
        self.recv_hz = 0.0
        self._count_t0 = time.time()
        self._count_n = 0

    def start(self):
        self.sock = socket.socket(socket.AF_INET, socket.SOCK_DGRAM)
        self.sock.bind((self.ip, self.port))
        self.sock.settimeout(0.1)
        self.running = True
        self.thread = threading.Thread(target=self._loop, daemon=True)
        self.thread.start()
        print(f"[JOINT UDP] Listen on {self.ip}:{self.port}")

    def stop(self):
        self.running = False
        try:
            if self.sock:
                self.sock.close()
        except Exception:
            pass

    def get_latest(self):
        with self.lock:
            return list(self.latest_deg), list(self.latest_order), self.seq, self.last_packet_time, self.recv_hz

    def _parse_packet(self, data: bytes):
        s = data.decode("utf-8", errors="ignore").strip()
        if not s:
            return None

        # Định dạng mới từ Raspberry: JSON type=ik12_deg, trường deg chứa đủ 12 góc IK raw sau tính toán.
        if s.startswith("{"):
            obj = json.loads(s)
            msg_type = str(obj.get("type", ""))
            if msg_type and msg_type not in ("ik12_deg", "joint_angles_deg"):
                return None
            deg = [float(x) for x in obj.get("deg", [])]
            if len(deg) != 12:
                return None
            order = obj.get("order", RAW_JOINT_ORDER)
            if len(order) != 12:
                order = RAW_JOINT_ORDER
            seq = int(obj.get("seq", 0))
            return deg, list(order), seq

        # Định dạng dự phòng khi gửi dạng text: IK12,<12 số>.
        upper = s.upper()
        for prefix in ("IK12", "RAWIK12", "IK12DEG", "RAW_IK12"):
            if upper.startswith(prefix):
                body = s[len(prefix):].strip(" :;,	")
                parts = body.replace(";", ",").replace(" ", ",").split(",")
                nums = []
                for p in parts:
                    p = p.strip()
                    if not p:
                        continue
                    try:
                        nums.append(float(p))
                    except Exception:
                        pass
                if len(nums) == 12:
                    return nums, list(RAW_JOINT_ORDER), 0
        return None

    def _loop(self):
        while self.running:
            try:
                data, _addr = self.sock.recvfrom(4096)
            except socket.timeout:
                continue
            except OSError:
                break
            except Exception as e:
                print("[JOINT UDP] recv error:", e)
                continue
            try:
                parsed = self._parse_packet(data)
            except Exception as e:
                print("[JOINT UDP] parse error:", e)
                continue
            if parsed is None:
                continue
            deg, order, seq = parsed
            now = time.time()
            with self.lock:
                self.latest_deg = deg
                self.latest_order = order
                self.seq = seq
                self.last_packet_time = now
                self._count_n += 1
                dt = now - self._count_t0
                if dt >= 1.0:
                    self.recv_hz = self._count_n / dt
                    self._count_n = 0
                    self._count_t0 = now


class JointMapperPanel:
    def __init__(self, parent):
        self.parent = parent
        self.mapping = [dict(x) for x in DEFAULT_JOINT_MAPPING]
        self.publish_enabled = tk.BooleanVar(value=bool(GAZEBO_PUBLISH_ENABLE))
        self.deg_to_rad_enabled = tk.BooleanVar(value=True)
        self.point_time_sec = tk.DoubleVar(value=JOINT_POINT_TIME_SEC)
        self.udp_port_var = tk.IntVar(value=JOINT_UDP_LISTEN_PORT)
        self.topic_var = tk.StringVar(value=JOINT_DEFAULT_TOPIC)
        self.receiver = None
        self.ros_node = None
        self.ros_thread = None
        self.ros_running = False
        self.ros_ready = False
        self.last_pub_time = 0.0
        self.pub_count = 0
        self.pub_hz = 0.0
        self._pub_count_t0 = time.time()
        self._pub_count_n = 0
        self.raw_deg = [0.0] * 12
        self.mapped_rad = [0.0] * 12
        self.ui_paused = False

        # Cache dữ liệu để publish liên tục cho Gazebo; việc cập nhật UDP/UI chạy riêng,
        # còn thread này giữ lệnh mới nhất và publish đều theo tần số đặt trước.
        self.pub_lock = threading.Lock()
        self.latest_joint_names = []
        self.latest_positions = []
        self.latest_seq_for_publish = -1
        self.publish_thread_running = True
        self.publish_thread = None

        self.load_config()
        self.build_ui()
        self.start_udp()
        self.start_ros()
        self.start_continuous_publish_thread()
        self.update_loop()

    def is_mapping_for_this_gazebo(self, mapping):
        wanted = {"JBL1", "JBL2", "JBL3", "JBR1", "JBR2", "JBR3", "JFL1", "JFL2", "JFL3", "JFR1", "JFR2", "JFR3"}
        try:
            joints = {str(m.get("joint", "")).strip() for m in mapping}
        except Exception:
            return False
        return wanted.issubset(joints)

    def force_default_mapping(self, save=False):
        self.mapping = [dict(x) for x in DEFAULT_JOINT_MAPPING]
        if hasattr(self, "tree"):
            self.refresh_tree_static()
        if save:
            cfg = {
                "mapping": self.mapping,
                "topic": self.topic_var.get().strip(),
                "point_time_sec": self.point_time_sec.get(),
                "deg_to_rad": self.deg_to_rad_enabled.get(),
                "publish_enabled": self.publish_enabled.get(),
                "udp_port": self.udp_port_var.get(),
            }
            try:
                with open(JOINT_CONFIG_PATH, "w", encoding="utf-8") as f:
                    json.dump(cfg, f, ensure_ascii=False, indent=2)
                print("[JOINT CONFIG] Saved default JBL/JBR/JFL/JFR mapping")
            except Exception as e:
                print("[JOINT CONFIG] save default error:", e)

    def load_config(self):
        if not os.path.exists(JOINT_CONFIG_PATH):
            self.force_default_mapping(save=False)
            return
        try:
            with open(JOINT_CONFIG_PATH, "r", encoding="utf-8") as f:
                cfg = json.load(f)
            loaded_mapping = cfg.get("mapping", self.mapping)

            # Nếu file cấu hình cũ còn các tên joint kiểu FL_hip_joint hoặc FR_thigh_joint thì bỏ qua và đặt lại mapping đúng cho Gazebo hiện tại.
            if not self.is_mapping_for_this_gazebo(loaded_mapping):
                print("[JOINT CONFIG] Old/invalid mapping detected -> reset to JBL/JBR/JFL/JFR")
                self.force_default_mapping(save=True)
            else:
                self.mapping = loaded_mapping

            self.topic_var.set(cfg.get("topic", self.topic_var.get()))
            self.point_time_sec.set(float(cfg.get("point_time_sec", self.point_time_sec.get())))
            self.deg_to_rad_enabled.set(bool(cfg.get("deg_to_rad", True)))
            self.publish_enabled.set(bool(cfg.get("publish_enabled", True)))
            self.udp_port_var.set(int(cfg.get("udp_port", JOINT_UDP_LISTEN_PORT)))
            print("[JOINT CONFIG] Loaded", JOINT_CONFIG_PATH)
        except Exception as e:
            print("[JOINT CONFIG] load error:", e)
            self.force_default_mapping(save=False)

    def save_config(self):
        self.read_mapping_from_table()
        cfg = {
            "mapping": self.mapping,
            "topic": self.topic_var.get().strip(),
            "point_time_sec": self.point_time_sec.get(),
            "deg_to_rad": self.deg_to_rad_enabled.get(),
            "publish_enabled": self.publish_enabled.get(),
            "udp_port": self.udp_port_var.get(),
        }
        try:
            with open(JOINT_CONFIG_PATH, "w", encoding="utf-8") as f:
                json.dump(cfg, f, ensure_ascii=False, indent=2)
            messagebox.showinfo("Lưu mapping", f"Đã lưu:\n{JOINT_CONFIG_PATH}")
        except Exception as e:
            messagebox.showerror("Lỗi lưu mapping", str(e))

    def build_ui(self):
        main = ttk.Frame(self.parent, style="TFrame", padding=16)
        main.pack(fill=tk.BOTH, expand=True)
        ttk.Label(main, text="MAPPING 12 GÓC CHÂN → GAZEBO", style="Title.TLabel").pack(anchor="w", pady=(0, 10))

        top = ttk.Frame(main, style="Panel.TFrame", padding=12)
        top.pack(fill=tk.X, pady=(0, 10))
        ttk.Label(top, text="UDP Port nhận 12 góc:", style="Info.TLabel").grid(row=0, column=0, sticky="w")
        ttk.Entry(top, textvariable=self.udp_port_var, width=8, font=("Consolas", 13)).grid(row=0, column=1, padx=(6, 14))
        ttk.Button(top, text="Restart UDP", style="Gray.TButton", command=self.restart_udp).grid(row=0, column=2, padx=(0, 16))
        ttk.Label(top, text="ROS Topic Gazebo:", style="Info.TLabel").grid(row=0, column=3, sticky="w")
        ttk.Entry(top, textvariable=self.topic_var, width=46, font=("Consolas", 13)).grid(row=0, column=4, padx=(6, 14))
        ttk.Button(top, text="Reconnect ROS", style="Blue.TButton", command=self.restart_ros).grid(row=0, column=5, padx=(0, 12))
        ttk.Checkbutton(top, text="Publish Gazebo", variable=self.publish_enabled).grid(row=1, column=0, sticky="w", pady=(8, 0))
        ttk.Checkbutton(top, text="deg → rad", variable=self.deg_to_rad_enabled).grid(row=1, column=1, sticky="w", pady=(8, 0))
        ttk.Label(top, text="Point time:", style="Info.TLabel").grid(row=1, column=3, sticky="w", pady=(8, 0))
        ttk.Entry(top, textvariable=self.point_time_sec, width=8, font=("Consolas", 13)).grid(row=1, column=4, sticky="w", padx=(6, 14), pady=(8, 0))
        ttk.Button(top, text="LƯU MAPPING", style="Green.TButton", command=self.save_config).grid(row=1, column=5, sticky="w", pady=(8, 0))
        ttk.Button(top, text="RESET JBL/JBR/JFL/JFR", style="Red.TButton", command=lambda: self.force_default_mapping(save=True)).grid(row=2, column=5, sticky="w", pady=(8, 0))

        self.status_label = ttk.Label(main, text="Status", style="BigImu.TLabel", padding=8)
        self.status_label.pack(fill=tk.X, pady=(0, 10))

        body = ttk.Frame(main, style="TFrame")
        body.pack(fill=tk.BOTH, expand=True)
        left = ttk.Frame(body, style="Panel.TFrame", padding=10)
        left.pack(side=tk.LEFT, fill=tk.BOTH, expand=True, padx=(0, 10))
        cols = ("src", "raw_deg", "joint", "sign", "offset", "mapped_rad", "enable")
        self.tree = ttk.Treeview(left, columns=cols, show="headings", height=15)
        headings = {"src":"Nguồn", "raw_deg":"Raw deg", "joint":"Gazebo joint name", "sign":"Sign", "offset":"Offset deg", "mapped_rad":"Mapped rad", "enable":"Enable"}
        widths = {"src":80, "raw_deg":100, "joint":260, "sign":70, "offset":105, "mapped_rad":120, "enable":80}
        for c in cols:
            self.tree.heading(c, text=headings[c])
            self.tree.column(c, width=widths[c], anchor="center")
        self.tree.pack(fill=tk.BOTH, expand=True)
        self.tree.bind("<Double-1>", self.on_tree_double_click)
        ttk.Label(left, text="Double click vào joint/sign/offset/enable để sửa. Enable nhập 1/0.", style="Info.TLabel").pack(anchor="w", pady=(8, 0))

        right = ttk.Frame(body, style="Panel.TFrame", padding=10, width=390)
        right.pack(side=tk.RIGHT, fill=tk.Y)
        right.pack_propagate(False)
        ttk.Label(right, text="Raw 12 góc từ Raspberry", style="SubTitle.TLabel").pack(anchor="w")
        self.raw_text = tk.Text(right, height=10, font=("Consolas", 12), bg="#f1f5f9")
        self.raw_text.pack(fill=tk.X, pady=(6, 12))
        ttk.Label(right, text="Mapped publish rad", style="SubTitle.TLabel").pack(anchor="w")
        self.map_text = tk.Text(right, height=10, font=("Consolas", 12), bg="#f1f5f9")
        self.map_text.pack(fill=tk.X, pady=(6, 12))
        hint = "Công thức:\n  mapped_rad = radians(raw_deg * sign + offset_deg)\n\nNếu Gazebo ngược chiều: sign = -1.\nNếu lệch zero: chỉnh offset_deg.\nTên joint phải đúng controller Gazebo."
        ttk.Label(right, text=hint, style="Info.TLabel", justify="left", wraplength=360).pack(anchor="w")
        self.refresh_tree_static()

    def refresh_tree_static(self):
        self.tree.delete(*self.tree.get_children())
        for i, m in enumerate(self.mapping):
            self.tree.insert("", "end", iid=str(i), values=(m.get("src", RAW_JOINT_ORDER[i]), "0.00", m.get("joint", ""), f"{float(m.get('sign', 1.0)):.1f}", f"{float(m.get('offset_deg', 0.0)):.2f}", "0.0000", "1" if m.get("enable", True) else "0"))

    def on_tree_double_click(self, event):
        region = self.tree.identify("region", event.x, event.y)
        if region != "cell":
            return
        row_id = self.tree.identify_row(event.y)
        col_id = self.tree.identify_column(event.x)
        if not row_id or not col_id:
            return
        col_index = int(col_id.replace("#", "")) - 1
        cols = ("src", "raw_deg", "joint", "sign", "offset", "mapped_rad", "enable")
        col = cols[col_index]
        if col not in ("joint", "sign", "offset", "enable"):
            return
        x, y, w, h = self.tree.bbox(row_id, col_id)
        old = self.tree.set(row_id, col)
        entry = ttk.Entry(self.tree)
        entry.place(x=x, y=y, width=w, height=h)
        entry.insert(0, old)
        entry.focus()
        def commit(_evt=None):
            val = entry.get().strip()
            self.tree.set(row_id, col, val)
            entry.destroy()
            self.read_mapping_from_table()
        entry.bind("<Return>", commit)
        entry.bind("<FocusOut>", commit)

    def read_mapping_from_table(self):
        new_map = []
        for i in range(12):
            vals = self.tree.item(str(i), "values")
            try:
                sign = float(vals[3])
            except Exception:
                sign = 1.0
            try:
                offset = float(vals[4])
            except Exception:
                offset = 0.0
            enable_txt = str(vals[6]).strip().lower()
            enable = enable_txt not in ("0", "false", "no", "off", "")
            new_map.append({"src": vals[0], "joint": vals[2], "sign": sign, "offset_deg": offset, "enable": enable})
        self.mapping = new_map

    def start_udp(self):
        if self.receiver:
            self.receiver.stop()
        self.receiver = UdpJointReceiver(JOINT_UDP_LISTEN_IP, int(self.udp_port_var.get()))
        self.receiver.start()

    def restart_udp(self):
        self.start_udp()

    def start_ros(self):
        if not ROS_OK:
            self.ros_ready = False
            print("[ROS] Not available:", ROS_ERR)
            return
        try:
            if not rclpy.ok():
                rclpy.init(args=None)
            self.ros_node = GazeboJointPublisher(self.topic_var.get().strip())
            self.ros_running = True
            self.ros_thread = threading.Thread(target=self._ros_spin_loop, daemon=True)
            self.ros_thread.start()
            self.ros_ready = True
            print("[ROS] Publishing to", self.topic_var.get().strip())
        except Exception as e:
            self.ros_ready = False
            print("[ROS] init error:", e)

    def restart_ros(self):
        try:
            if self.ros_node:
                self.ros_node.destroy_node()
        except Exception:
            pass
        self.ros_node = None
        self.ros_ready = False
        self.start_ros()

    def _ros_spin_loop(self):
        while self.ros_running and self.ros_node is not None:
            try:
                rclpy.spin_once(self.ros_node, timeout_sec=0.02)
            except Exception:
                time.sleep(0.05)

    def compute_mapping(self, raw_deg: List[float]):
        self.read_mapping_from_table()

        mapped_all = []
        joint_to_val = {}
        joint_enable = {}

        for i, m in enumerate(self.mapping):
            raw = raw_deg[i]
            deg = raw * float(m.get("sign", 1.0)) + float(m.get("offset_deg", 0.0))
            val = math.radians(deg) if self.deg_to_rad_enabled.get() else deg
            mapped_all.append(val)

            joint = str(m.get("joint", "")).strip()
            if joint:
                joint_to_val[joint] = val
                joint_enable[joint] = bool(m.get("enable", True))

        # Publish theo đúng thứ tự controller Gazebo yêu cầu: JFL, JFR, JBL, JBR.
        # Thứ tự publish không phụ thuộc vào thứ tự hiển thị trong bảng.
        joint_names = []
        positions = []
        for joint in GAZEBO_PUBLISH_ORDER:
            if joint_enable.get(joint, False) and joint in joint_to_val:
                joint_names.append(joint)
                positions.append(joint_to_val[joint])

        return joint_names, positions, mapped_all

    def update_publish_cache(self, joint_names: List[str], positions: List[float], seq: int):
        if not joint_names or not positions:
            return
        if len(joint_names) != len(positions):
            return
        with self.pub_lock:
            self.latest_joint_names = list(joint_names)
            self.latest_positions = [float(x) for x in positions]
            self.latest_seq_for_publish = int(seq)

    def start_continuous_publish_thread(self):
        if self.publish_thread is not None and self.publish_thread.is_alive():
            return
        self.publish_thread_running = True
        self.publish_thread = threading.Thread(target=self._continuous_publish_loop, daemon=True)
        self.publish_thread.start()

    def _continuous_publish_loop(self):
        # Publish liên tục theo cấu hình Gazebo: tần số mục tiêu và time_from_start do GUI thiết lập.
        # Không phụ thuộc tốc độ refresh GUI, giúp Gazebo nhận lệnh đều hơn khi robot di chuyển.
        next_t = time.time()
        while self.publish_thread_running:
            hz = max(1.0, float(JOINT_PUBLISH_HZ_LIMIT))
            period = 1.0 / hz
            next_t += period

            if self.publish_enabled.get() and self.ros_ready and self.ros_node is not None:
                with self.pub_lock:
                    joint_names = list(self.latest_joint_names)
                    positions = list(self.latest_positions)

                if joint_names and positions and len(joint_names) == len(positions):
                    try:
                        self.ros_node.publish_positions(joint_names, positions, float(self.point_time_sec.get()))
                        now_pub = time.time()
                        self.last_pub_time = now_pub
                        self.pub_count += 1
                        self._pub_count_n += 1
                        dt_pub = now_pub - self._pub_count_t0
                        if dt_pub >= 1.0:
                            self.pub_hz = self._pub_count_n / dt_pub
                            self._pub_count_n = 0
                            self._pub_count_t0 = now_pub
                    except Exception as e:
                        print("[ROS] continuous publish error:", e)
                        time.sleep(0.05)

            sleep_t = next_t - time.time()
            if sleep_t > 0:
                time.sleep(sleep_t)
            else:
                # Nếu GUI hoặc ROS bị nghẽn, reset nhịp để không dồn các lệnh cũ.
                next_t = time.time()

    def set_ui_paused(self, paused: bool):
        # Chỉ dừng cập nhật bảng, tree và text trong tab mapping ẩn.
        # Bộ nhận UDP IK12 vẫn chạy; publish sẽ được bật hoặc tắt riêng.
        self.ui_paused = bool(paused)

    def get_runtime_stats(self):
        """Trả về tần số nhận IK12 và tần số publish sang Gazebo để hiển thị trên tab Gazebo."""
        raw_deg, order, seq, last_t, recv_hz = self.receiver.get_latest() if self.receiver else ([0.0]*12, RAW_JOINT_ORDER, 0, 0, 0)
        now = time.time()
        rx_age = now - last_t if last_t > 0 else 999.0
        pub_age = now - self.last_pub_time if self.last_pub_time > 0 else 999.0
        return {
            "seq": seq,
            "rx_hz": float(recv_hz),
            "rx_age": float(rx_age),
            "pub_hz": float(self.pub_hz),
            "pub_age": float(pub_age),
            "pub_count": int(self.pub_count),
            "target_hz": float(JOINT_PUBLISH_HZ_LIMIT),
            "publish_enabled": bool(self.publish_enabled.get()),
        }

    def update_loop(self):
        if not hasattr(self.parent, "winfo_exists") or not self.parent.winfo_exists():
            return
        if getattr(self, "ui_paused", False):
            self.parent.after(max(200, JOINT_UI_UPDATE_MS), self.update_loop)
            return
        raw_deg, order, seq, last_t, recv_hz = self.receiver.get_latest() if self.receiver else ([0.0]*12, RAW_JOINT_ORDER, 0, 0, 0)
        joint_names, positions, mapped_all = self.compute_mapping(raw_deg)
        self.update_publish_cache(joint_names, positions, seq)
        age = time.time() - last_t if last_t > 0 else 999
        rx_state = "OK" if age < 1.0 else "WAIT"
        ros_state = "OK" if self.ros_ready else f"NO ROS ({ROS_ERR[:55]})"
        pub_age = time.time() - self.last_pub_time if self.last_pub_time > 0 else 999
        pub_state = "OK" if pub_age < 1.0 else "WAIT"
        self.status_label.config(
            text=(
                f"UDP {rx_state} | seq={seq} | IK12 rx={recv_hz:.1f} Hz | "
                f"ROS={ros_state} | GZB pub={self.pub_hz:.1f} Hz/{JOINT_PUBLISH_HZ_LIMIT:.0f} Hz | "
                f"pub_state={pub_state} | count={self.pub_count}"
            )
        )
        for i in range(12):
            iid = str(i)
            if self.tree.exists(iid):
                self.tree.set(iid, "raw_deg", f"{raw_deg[i]:.2f}")
                self.tree.set(iid, "mapped_rad", f"{mapped_all[i]:.4f}")
        self.raw_text.delete("1.0", tk.END)
        for i, name in enumerate(RAW_JOINT_ORDER):
            self.raw_text.insert(tk.END, f"{name:6s}: {raw_deg[i]:8.2f} deg\n")
        self.map_text.delete("1.0", tk.END)
        for i, m in enumerate(self.mapping):
            self.map_text.insert(tk.END, f"{m.get('joint','')[:18]:18s}: {mapped_all[i]:+8.4f} rad\n")
        self.parent.after(JOINT_UI_UPDATE_MS, self.update_loop)

    def close(self):
        self.publish_thread_running = False
        try:
            if self.receiver:
                self.receiver.stop()
        except Exception:
            pass
        self.ros_running = False
        try:
            if self.ros_node:
                self.ros_node.destroy_node()
        except Exception:
            pass


class GazeboImuNode(Node):
    def __init__(self, topic: str):
        super().__init__("gazebo_imu_compare_gui")
        self.topic = topic
        self.lock = threading.Lock()
        self.roll = 0.0
        self.pitch = 0.0
        self.yaw = 0.0
        self.last_time = 0.0
        self.recv_count = 0
        self.create_subscription(Imu, topic, self.imu_callback, 10)

    @staticmethod
    def quat_to_rpy_deg(q):
        sinr_cosp = 2.0 * (q.w * q.x + q.y * q.z)
        cosr_cosp = 1.0 - 2.0 * (q.x * q.x + q.y * q.y)
        roll = math.degrees(math.atan2(sinr_cosp, cosr_cosp))

        sinp = 2.0 * (q.w * q.y - q.z * q.x)
        sinp = max(-1.0, min(1.0, sinp))
        pitch = math.degrees(math.asin(sinp))

        siny_cosp = 2.0 * (q.w * q.z + q.x * q.y)
        cosy_cosp = 1.0 - 2.0 * (q.y * q.y + q.z * q.z)
        yaw = math.degrees(math.atan2(siny_cosp, cosy_cosp))
        return roll, pitch, yaw

    def imu_callback(self, msg):
        roll, pitch, yaw = self.quat_to_rpy_deg(msg.orientation)
        with self.lock:
            self.roll = roll
            self.pitch = pitch
            self.yaw = yaw
            self.last_time = time.time()
            self.recv_count += 1

    def get_imu(self):
        with self.lock:
            return self.roll, self.pitch, self.yaw, self.last_time, self.recv_count


class GazeboImuComparePanel:
    """Tab Gazebo chỉ dùng để so sánh IMU mô phỏng và IMU thực tế.

    JointMapperPanel vẫn chạy ẩn phía sau để nhận IK12 và publish JointTrajectory cho Gazebo.
    """
    def __init__(self, parent, app, hidden_joint_panel=None):
        self.parent = parent
        self.app = app
        self.hidden_joint_panel = hidden_joint_panel
        self.gazebo_node = None
        self.ros_thread = None
        self.ros_running = False
        self.ros_ready = False
        self.ros_error = ""

        self.t0 = time.time()
        self.t_data = deque(maxlen=GAZEBO_IMU_PLOT_MAX_POINTS)
        self.real_roll = deque(maxlen=GAZEBO_IMU_PLOT_MAX_POINTS)
        self.real_pitch = deque(maxlen=GAZEBO_IMU_PLOT_MAX_POINTS)
        self.real_yaw = deque(maxlen=GAZEBO_IMU_PLOT_MAX_POINTS)
        self.gz_roll = deque(maxlen=GAZEBO_IMU_PLOT_MAX_POINTS)
        self.gz_pitch = deque(maxlen=GAZEBO_IMU_PLOT_MAX_POINTS)
        self.gz_yaw = deque(maxlen=GAZEBO_IMU_PLOT_MAX_POINTS)

        self.build_ui()
        self.start_ros_imu()
        self.update_loop()

    def build_ui(self):
        main = ttk.Frame(self.parent, style="TFrame", padding=16)
        main.pack(fill=tk.BOTH, expand=True)

        title_row = ttk.Frame(main, style="TFrame")
        title_row.pack(fill=tk.X, pady=(0, 8))
        ttk.Label(title_row, text="GAZEBO - SO SÁNH IMU MÔ PHỎNG VÀ THỰC TẾ", style="Title.TLabel").pack(side=tk.LEFT)

        info = ttk.Frame(main, style="Panel.TFrame", padding=12)
        info.pack(fill=tk.X, pady=(0, 10))

        ttk.Label(info, text="Gazebo IMU topic:", style="Info.TLabel").grid(row=0, column=0, sticky="w", padx=(0, 8))
        self.topic_var = tk.StringVar(value=GAZEBO_IMU_TOPIC)
        ttk.Entry(info, textvariable=self.topic_var, width=28, font=("Consolas", 14)).grid(row=0, column=1, sticky="w", padx=(0, 8))
        ttk.Button(info, text="Reconnect IMU Gazebo", style="Blue.TButton", command=self.reconnect_ros_imu).grid(row=0, column=2, padx=(0, 12))

        self.status_label = ttk.Label(info, text="Gazebo IMU: waiting... | Real IMU: waiting...", style="BigImu.TLabel", padding=8)
        self.status_label.grid(row=1, column=0, columnspan=4, sticky="ew", pady=(10, 0))
        info.columnconfigure(3, weight=1)

        values = ttk.Frame(main, style="Panel.TFrame", padding=12)
        values.pack(fill=tk.X, pady=(0, 10))
        self.real_value_label = ttk.Label(values, text="IMU thực tế: Roll 0.00° | Pitch 0.00° | Yaw 0.00°", style="Info.TLabel")
        self.gz_value_label = ttk.Label(values, text="IMU Gazebo: Roll 0.00° | Pitch 0.00° | Yaw 0.00°", style="Info.TLabel")
        self.freq_value_label = ttk.Label(
            values,
            text="Tần số: IK12 đọc 0.0 Hz | Publish GZB 0.0 Hz | Target 0.0 Hz",
            style="BigImu.TLabel",
            padding=6
        )
        self.real_value_label.pack(anchor="w")
        self.gz_value_label.pack(anchor="w", pady=(4, 0))
        self.freq_value_label.pack(anchor="w", fill=tk.X, pady=(8, 0))

        self.fig = Figure(figsize=(15, 7.5), dpi=100, facecolor="#ffffff")
        self.ax_roll = self.fig.add_subplot(311)
        self.ax_pitch = self.fig.add_subplot(312)
        self.ax_yaw = self.fig.add_subplot(313)

        self.line_real_roll, = self.ax_roll.plot([], [], linewidth=2.0, label="Real Roll", color="tab:blue")
        self.line_gz_roll, = self.ax_roll.plot([], [], linewidth=2.0, linestyle="--", label="Gazebo Roll", color="tab:cyan")
        self.line_real_pitch, = self.ax_pitch.plot([], [], linewidth=2.0, label="Real Pitch", color="tab:orange")
        self.line_gz_pitch, = self.ax_pitch.plot([], [], linewidth=2.0, linestyle="--", label="Gazebo Pitch", color="tab:red")
        self.line_real_yaw, = self.ax_yaw.plot([], [], linewidth=2.0, label="Real Yaw", color="tab:green")
        self.line_gz_yaw, = self.ax_yaw.plot([], [], linewidth=2.0, linestyle="--", label="Gazebo Yaw", color="tab:purple")

        for ax, title, ylim in [
            (self.ax_roll, "ROLL: thực tế vs Gazebo", ROLL_YLIM),
            (self.ax_pitch, "PITCH: thực tế vs Gazebo", PITCH_YLIM),
            (self.ax_yaw, "YAW: thực tế vs Gazebo", YAW_YLIM),
        ]:
            ax.set_facecolor("#ffffff")
            ax.set_title(title, fontsize=13, fontweight="bold", color="#0f172a")
            ax.set_ylabel("deg", fontsize=11)
            ax.set_ylim(*ylim)
            ax.grid(True, color="#cbd5e1", linewidth=0.8)
            ax.legend(loc="upper right", fontsize=9, facecolor="#ffffff", edgecolor="#cbd5e1")
            for spine in ax.spines.values():
                spine.set_color("#94a3b8")
        self.ax_yaw.set_xlabel("Time (s)", fontsize=11)
        self.fig.tight_layout(pad=1.5)

        self.canvas = FigureCanvasTkAgg(self.fig, master=main)
        self.canvas.get_tk_widget().configure(bg="#ffffff", highlightthickness=0)
        self.canvas.get_tk_widget().pack(fill=tk.BOTH, expand=True)

        self.help_label = ttk.Label(
            main,
            text="Tab này hiển thị IMU + tần số IK12 đọc được + tần số publish JointTrajectory sang Gazebo. Phần mapping IK12 vẫn chạy ẩn phía sau.",
            style="Small.TLabel"
        )
        self.help_label.pack(anchor="w", pady=(8, 0))

    def start_ros_imu(self):
        if not ROS_OK:
            self.ros_error = ROS_ERR
            self.ros_ready = False
            return
        try:
            if not rclpy.ok():
                rclpy.init(args=None)
            self.gazebo_node = GazeboImuNode(self.topic_var.get().strip())
            self.ros_running = True
            self.ros_ready = True
            self.ros_thread = threading.Thread(target=self._ros_spin_loop, daemon=True)
            self.ros_thread.start()
        except Exception as e:
            self.ros_error = str(e)
            self.ros_ready = False

    def reconnect_ros_imu(self):
        self.close_ros_only()
        self.start_ros_imu()

    def _ros_spin_loop(self):
        while self.ros_running and self.gazebo_node is not None:
            try:
                rclpy.spin_once(self.gazebo_node, timeout_sec=0.02)
            except Exception as e:
                self.ros_error = str(e)
                self.ros_ready = False
                time.sleep(0.05)

    def close_ros_only(self):
        self.ros_running = False
        try:
            if self.gazebo_node is not None:
                self.gazebo_node.destroy_node()
        except Exception:
            pass
        self.gazebo_node = None
        self.ros_ready = False

    def update_loop(self):
        if not hasattr(self.parent, "winfo_exists") or not self.parent.winfo_exists():
            return

        # Khi đang ở tab Balance, tạm dừng vẽ plot Gazebo để nhường CPU cho đồ thị Balance.
        if (bool(BALANCE_PAUSE_GAZEBO_IMU_PLOT)
                and getattr(self.app, "balance_focus_mode", False)):
            self.parent.after(max(250, GAZEBO_IMU_PLOT_UPDATE_MS), self.update_loop)
            return

        # IMU thực tế nhận từ Raspberry qua UDP 7007.
        real_r = real_p = real_y = 0.0
        real_t = 0.0
        if getattr(self.app, "udp_imu", None) is not None:
            real_r, real_p, real_y, real_t = self.app.udp_imu.get_imu()

        # IMU mô phỏng nhận từ ROS topic /imu.
        gz_r = gz_p = gz_y = 0.0
        gz_t = 0.0
        gz_count = 0
        if self.gazebo_node is not None:
            gz_r, gz_p, gz_y, gz_t, gz_count = self.gazebo_node.get_imu()

        now = time.time()
        t = now - self.t0
        self.t_data.append(t)
        self.real_roll.append(real_r)
        self.real_pitch.append(real_p)
        self.real_yaw.append(real_y)
        self.gz_roll.append(gz_r)
        self.gz_pitch.append(gz_p)
        self.gz_yaw.append(gz_y)

        real_ok = (now - real_t) < 2.0 if real_t > 0 else False
        gz_ok = (now - gz_t) < 2.0 if gz_t > 0 else False

        hz_info = {
            "seq": 0,
            "rx_hz": 0.0,
            "rx_age": 999.0,
            "pub_hz": 0.0,
            "pub_age": 999.0,
            "pub_count": 0,
            "target_hz": float(JOINT_PUBLISH_HZ_LIMIT),
            "publish_enabled": False,
        }
        if self.hidden_joint_panel is not None:
            try:
                hz_info.update(self.hidden_joint_panel.get_runtime_stats())
            except Exception:
                hz_info["pub_count"] = getattr(self.hidden_joint_panel, "pub_count", 0)
                hz_info["pub_hz"] = getattr(self.hidden_joint_panel, "pub_hz", 0.0)

        ik12_ok = hz_info["rx_age"] < 1.0
        pub_ok = hz_info["pub_age"] < 1.0 and hz_info["publish_enabled"]
        hidden_status = (
            f" | IK12 rx={hz_info['rx_hz']:.1f}Hz ({'OK' if ik12_ok else 'WAIT'})"
            f" | GZB pub={hz_info['pub_hz']:.1f}Hz ({'OK' if pub_ok else 'WAIT/OFF'})"
        )

        self.status_label.config(
            text=f"Gazebo IMU: {'OK' if gz_ok else 'WAIT'} | Real IMU: {'OK' if real_ok else 'WAIT'} | ROS: {'OK' if self.ros_ready else self.ros_error[:45]}{hidden_status}"
        )
        self.real_value_label.config(text=f"IMU thực tế: Roll {real_r:+7.2f}° | Pitch {real_p:+7.2f}° | Yaw {real_y:+7.2f}°")
        self.gz_value_label.config(text=f"IMU Gazebo: Roll {gz_r:+7.2f}° | Pitch {gz_p:+7.2f}° | Yaw {gz_y:+7.2f}°")
        self.freq_value_label.config(
            text=(
                f"Tần số: IK12 đọc {hz_info['rx_hz']:.1f} Hz | "
                f"Publish GZB {hz_info['pub_hz']:.1f} Hz / Target {hz_info['target_hz']:.1f} Hz | "
                f"seq={hz_info['seq']} | count={hz_info['pub_count']} | "
                f"{'PUB ON' if hz_info['publish_enabled'] else 'PUB OFF'}"
            )
        )

        xs = list(self.t_data)
        self.line_real_roll.set_data(xs, list(self.real_roll))
        self.line_gz_roll.set_data(xs, list(self.gz_roll))
        self.line_real_pitch.set_data(xs, list(self.real_pitch))
        self.line_gz_pitch.set_data(xs, list(self.gz_pitch))
        self.line_real_yaw.set_data(xs, list(self.real_yaw))
        self.line_gz_yaw.set_data(xs, list(self.gz_yaw))

        if len(xs) >= 2:
            xmin = max(0.0, xs[-1] - GAZEBO_IMU_PLOT_WINDOW_SEC)
            xmax = xs[-1] + 0.5
            for ax in (self.ax_roll, self.ax_pitch, self.ax_yaw):
                ax.set_xlim(xmin, xmax)

        self.canvas.draw_idle()
        self.parent.after(GAZEBO_IMU_PLOT_UPDATE_MS, self.update_loop)

    def close(self):
        self.close_ros_only()



class CamPidApp:
    def __init__(self, root):
        self.root = root
        self.root.title("Camera PID + IMU Plot - UDP Raspberry - FULLSCREEN")
        self.root.geometry("1920x1080")
        self.root.minsize(1350, 760)
        self.root.protocol("WM_DELETE_WINDOW", self.on_close)
        self.root.configure(bg="#f8fafc")

        # Mặc định mở giao diện toàn màn hình.
        self.fullscreen = True
        self.root.attributes("-fullscreen", True)

        self.pose = None
        self.udp_cam = None
        self.udp_imu = None

        self.offset_sock = socket.socket(socket.AF_INET, socket.SOCK_DGRAM)

        self.running = True
        self.send_camera_data = True
        self.cam_pid_enabled = False

        # Chế độ ưu tiên Balance: khi vào tab Balance, tạm dừng các tác vụ nặng để đồ thị IMU mượt hơn.
        self.balance_focus_mode = False
        self._balance_saved_send_camera_data = True
        self._balance_saved_gazebo_publish = None
        self._balance_last_tab_text = ""

        self.last_send_time = 0.0
        self.prev_time = time.time()
        self.fps = 0.0

        # Cache xử lý camera: dùng để giảm tải MediaPipe bằng cách xử lý cách frame.
        self.cam_frame_count = 0
        self.last_processed_output = None

        self.detected_val = 0
        self.full_body_ok = False

        self.offset_x = 0
        self.direction = "NO_PERSON"
        self.box_width = 0
        self.box_height = 0
        self.person_center_x = 0
        self.person_center_y = 0
        self.last_status_msg = "Ready"

        self.lpf_ready = False
        self.f_offset_x = 0.0
        self.f_box_width = 0.0
        self.f_box_height = 0.0
        self.f_center_x = 0.0
        self.f_center_y = 0.0

        # Snapshot offset camera để file REC CSV lưu được cả raw, LPF và offset thực tế gửi xuống bridge.
        self.offset_record_seq = 0
        self.offset_last_update_time = 0.0
        self.offset_record_snapshot = {
            "seq": 0,
            "unix_time": 0.0,
            "cam_pid_enabled": 0,
            "mediapipe_enabled": 0,
            "detected": 0,
            "full_body_ok": 0,
            "direction": "INIT",
            "offset_x_raw_px": 0.0,
            "offset_x_lpf_px": 0.0,
            "offset_x_send_px": 0.0,
            "offset_box_width_scale": 1.0,
            "offset_scale_ref_box_w_px": float(OFFSET_SCALE_REF_BOX_W),
            "offset_scale_enabled": int(OFFSET_SCALE_BY_BOX_W_ENABLE),
            "box_width_raw_px": 0.0,
            "box_width_lpf_px": 0.0,
            "box_height_raw_px": 0.0,
            "box_height_lpf_px": 0.0,
            "center_x_raw_px": 0.0,
            "center_x_lpf_px": 0.0,
            "center_y_raw_px": 0.0,
            "center_y_lpf_px": 0.0,
        }

        self.esp_box_status = "BOX H: waiting..."
        self.last_udp_msg = "None"

        # Dữ liệu đồ thị IMU.
        self.t0 = time.time()
        self.t_data = deque(maxlen=PLOT_MAX_POINTS)
        self.roll_data = deque(maxlen=PLOT_MAX_POINTS)
        self.pitch_data = deque(maxlen=PLOT_MAX_POINTS)
        self.yaw_data = deque(maxlen=PLOT_MAX_POINTS)

        # Ghi dữ liệu IMU thực tế nhận từ Raspberry qua UDP 7007.
        self.rec_enabled = False
        self.rec_folder = REC_DEFAULT_DIR
        self.rec_file_path = None
        self.rec_file = None
        self.rec_writer = None
        self.rec_start_time = 0.0
        self.rec_samples = 0
        self.rec_last_t_last = 0.0
        self.rec_last_seq = 0
        self.rec_status_labels = []

        # Tab Balance và PID SBAL.
        self.sbal_kp_var = tk.StringVar(value="0.1")
        self.sbal_ki_var = tk.StringVar(value="1.5")
        self.sbal_kd_var = tk.StringVar(value="0.0")
        self.sbal_maxx_var = tk.StringVar(value="80")
        self.sbal_deadband_var = tk.StringVar(value="0.1")
        self.sbal_hold_var = tk.StringVar(value="0.25")
        self.sbal_imax_var = tk.StringVar(value="40")
        self.sbal_roll_sp_var = tk.StringVar(value="0")
        self.sbal_pitch_sp_var = tk.StringVar(value="0")
        self.sbal_sp_limit_deg = 15.0
        self.sbal_joy_size = 210
        self.sbal_joy_center = self.sbal_joy_size / 2
        self.sbal_joy_radius = 82
        self.sbal_joy_knob_radius = 13
        self.sbal_last_sp_send_time = 0.0
        self.sbal_sp_send_interval = 0.10
        self.sbal_plot_window_sec = 20.0
        self.sbal_plot_max_points = 600
        self.sbal_plot_t0 = time.time()
        self.sbal_plot_t = deque(maxlen=self.sbal_plot_max_points)
        self.sbal_plot_roll = deque(maxlen=self.sbal_plot_max_points)
        self.sbal_plot_pitch = deque(maxlen=self.sbal_plot_max_points)
        self.sbal_plot_last_seq = 0
        self.sbal_plot_hz = 0.0
        self.sbal_plot_count_n = 0
        self.sbal_plot_count_t0 = time.time()
        # Bộ lọc hiển thị Balance chỉ làm mượt đường vẽ, không ảnh hưởng dữ liệu ghi CSV.
        self.sbal_plot_filter_ready = False
        self.sbal_plot_roll_f = 0.0
        self.sbal_plot_pitch_f = 0.0
        self.sbal_plot_spike_count = 0
        self.sbal_plot_spike_count_window = 0

        # Điều chỉnh trục X/chiều cao gait thông qua ESP bằng các lệnh X+, X- và X_RESET.
        # Cần khởi tạo trước build_ui() vì label X sử dụng self.height_x.
        self.height_x = HEIGHT_DEFAULT_X
        self.height_step_x = HEIGHT_STEP_X
        self.height_min_x = HEIGHT_MIN_X
        self.height_max_x = HEIGHT_MAX_X

        # Tab tinh chỉnh gait.
        self.gait_vars = {}
        self.gait_status_label = None
        self.init_gait_config_vars()

        self.setting_vars = {}

        self.pose_vars = {}
        self.pose_status_label = None
        for pose_name, legs in POSE_DEFAULTS.items():
            self.pose_vars[pose_name] = {}
            for leg in POSE_LEGS:
                self.pose_vars[pose_name][leg] = {}
                for i, axis in enumerate(POSE_AXES):
                    self.pose_vars[pose_name][leg][axis] = tk.StringVar(value=f"{legs[leg][i]:.1f}")
        self.load_saved_config()

        self.setup_style()
        self.build_ui()

        self.init_mediapipe()
        self.init_udp_camera()
        self.init_udp_imu()

        self.update_frame()
        self.update_imu_plot()

    # ================== GIAO DIỆN ==================
    def setup_style(self):
        style = ttk.Style()
        style.theme_use("clam")

        style.configure(
            "TNotebook",
            background="#f8fafc",
            borderwidth=0,
            tabmargins=(4, 4, 4, 0)
        )

        # Tab đang chọn được hiển thị lớn hơn, sáng hơn và nổi bật hơn các tab còn lại.
        style.configure(
            "TNotebook.Tab",
            font=("Segoe UI", 14, "bold"),
            padding=(16, 9),
            background="#d1d5db",
            foreground="#475569",
            borderwidth=1
        )

        style.map(
            "TNotebook.Tab",
            background=[
                ("selected", "#ffffff"),
                ("!selected", "#d1d5db")
            ],
            foreground=[
                ("selected", "#0f172a"),
                ("!selected", "#475569")
            ],
            padding=[
                ("selected", (26, 15)),
                ("!selected", (16, 9))
            ],
            expand=[
                ("selected", (0, 0, 0, 4)),
                ("!selected", (0, 0, 0, 0))
            ]
        )

        style.configure("TFrame", background="#f8fafc")
        style.configure("Panel.TFrame", background="#ffffff")

        style.configure(
            "Title.TLabel",
            background="#f8fafc",
            foreground="#0f172a",
            font=("Segoe UI", 28, "bold")
        )

        style.configure(
            "School.TLabel",
            background="#f8fafc",
            foreground="#0369a1",
            font=("Segoe UI", 20, "bold")
        )

        style.configure(
            "Project.TLabel",
            background="#f8fafc",
            foreground="#92400e",
            font=("Segoe UI", 19, "bold")
        )

        style.configure(
            "Author.TLabel",
            background="#f8fafc",
            foreground="#334155",
            font=("Segoe UI", 16, "bold")
        )

        style.configure(
            "SubTitle.TLabel",
            background="#ffffff",
            foreground="#0f172a",
            font=("Segoe UI", 19, "bold")
        )

        style.configure(
            "Info.TLabel",
            background="#ffffff",
            foreground="#1e293b",
            font=("Consolas", 15)
        )

        style.configure(
            "BigImu.TLabel",
            background="#f1f5f9",
            foreground="#166534",
            font=("Consolas", 20, "bold")
        )

        style.configure(
            "Small.TLabel",
            background="#ffffff",
            foreground="#475569",
            font=("Segoe UI", 13)
        )

        style.configure(
            "Status.TLabel",
            background="#ffffff",
            foreground="#166534",
            font=("Consolas", 14)
        )

        style.configure(
            "DateTime.TLabel",
            background="#f8fafc",
            foreground="#0f172a",
            font=("Consolas", 15, "bold")
        )

        style.configure(
            "Debug.TLabel",
            background="#f1f5f9",
            foreground="#92400e",
            font=("Consolas", 13)
        )

        style.configure("TButton", font=("Segoe UI", 15, "bold"), padding=12)
        style.configure("Compact.TButton", font=("Segoe UI", 12, "bold"), padding=(8, 7))
        style.configure("CompactGreen.TButton", font=("Segoe UI", 12, "bold"), padding=(8, 7), background="#15803d", foreground="#ffffff")
        style.configure("CompactRed.TButton", font=("Segoe UI", 12, "bold"), padding=(8, 7), background="#b91c1c", foreground="#ffffff")
        style.configure("CompactBlue.TButton", font=("Segoe UI", 12, "bold"), padding=(8, 7), background="#2563eb", foreground="#ffffff")
        style.configure("CompactGray.TButton", font=("Segoe UI", 12, "bold"), padding=(8, 7), background="#475569", foreground="#ffffff")
        style.configure("Green.TButton", background="#15803d", foreground="#ffffff")
        style.configure("Red.TButton", background="#b91c1c", foreground="#ffffff")
        style.configure("Blue.TButton", background="#2563eb", foreground="#ffffff")
        style.configure("Gray.TButton", background="#475569", foreground="#ffffff")
        style.map("Green.TButton", background=[("active", "#16a34a")])
        style.map("Red.TButton", background=[("active", "#dc2626")])
        style.map("Blue.TButton", background=[("active", "#3b82f6")])
        style.map("Gray.TButton", background=[("active", "#64748b")])

    def find_logo_path(self, candidates):
        search_dirs = [
            os.path.dirname(os.path.abspath(__file__)),
            os.path.expanduser("~/Desktop"),
            os.path.expanduser("~/Downloads"),
            os.path.expanduser("~/Pictures"),
            os.path.expanduser("~/logo"),
        ]

        for folder in search_dirs:
            for name in candidates:
                path = os.path.join(folder, name)
                if os.path.exists(path):
                    return path
        return None

    def load_logo_image(self, candidates, target_height):
        path = self.find_logo_path(candidates)
        if not path:
            return None

        try:
            img = Image.open(path).convert("RGBA")
            scale = target_height / max(img.height, 1)
            new_w = max(1, int(img.width * scale))
            img = img.resize((new_w, target_height), Image.Resampling.LANCZOS)
            return ImageTk.PhotoImage(img)
        except Exception as e:
            print(f"[LOGO] Không load được {path}: {e}")
            return None

    def build_header_with_logos(self, parent):
        header_info = ttk.Frame(parent, style="TFrame")
        header_info.pack(fill=tk.X, pady=(0, 8))

        group_wrap = ttk.Frame(header_info, style="TFrame")
        group_wrap.pack(anchor="center")
        group_wrap.columnconfigure(1, weight=0)

        left_logo_h = int(UTE_LOGO_TARGET_HEIGHT * FEEE_LOGO_HEIGHT_RATIO)
        right_logo_h = UTE_LOGO_TARGET_HEIGHT

        self.left_logo_imgtk = self.load_logo_image(LEFT_LOGO_FILES, left_logo_h)
        self.right_logo_imgtk = self.load_logo_image(RIGHT_LOGO_FILES, right_logo_h)

        left_wrap = ttk.Frame(group_wrap, style="TFrame")
        left_wrap.grid(row=0, column=0, padx=(0, LOGO_TEXT_GAP_X), pady=(4, 0))

        center_wrap = ttk.Frame(group_wrap, style="TFrame")
        center_wrap.grid(row=0, column=1, padx=(0, 0), pady=(0, 0))

        right_wrap = ttk.Frame(group_wrap, style="TFrame")
        right_wrap.grid(row=0, column=2, padx=(LOGO_TEXT_GAP_X, 0), pady=(4, 0))

        if self.left_logo_imgtk is not None:
            ttk.Label(left_wrap, image=self.left_logo_imgtk, background="#f8fafc").pack()
        else:
            ttk.Label(left_wrap, text="", style="Author.TLabel").pack()

        if self.right_logo_imgtk is not None:
            ttk.Label(right_wrap, image=self.right_logo_imgtk, background="#f8fafc").pack()
        else:
            ttk.Label(right_wrap, text="", style="Author.TLabel").pack()

        ttk.Label(
            center_wrap,
            text=UNIVERSITY_NAME,
            style="School.TLabel",
            anchor="center",
            justify="center"
        ).pack(anchor="center")

        ttk.Label(
            center_wrap,
            text=PROJECT_TITLE,
            style="Project.TLabel",
            anchor="center",
            justify="center"
        ).pack(anchor="center", pady=(2, 0))

        ttk.Label(
            center_wrap,
            text=SUPERVISOR_NAME,
            style="Author.TLabel",
            anchor="center",
            justify="center"
        ).pack(anchor="center", pady=(2, 0))

        ttk.Label(
            center_wrap,
            text=STUDENT_NAMES,
            style="Author.TLabel",
            anchor="center",
            justify="center"
        ).pack(anchor="center", pady=(2, 0))

    def build_ui(self):
        self.notebook = ttk.Notebook(self.root)
        self.notebook.pack(fill=tk.BOTH, expand=True)

        # Hiển thị ngày giờ ở góc phải phía trên.
        self.datetime_label = ttk.Label(self.root, text="", style="DateTime.TLabel")
        self.datetime_label.place(relx=1.0, x=-18, y=12, anchor="ne")
        self.update_datetime_label()

        monitor_tab = ttk.Frame(self.notebook, style="TFrame")
        settings_tab = ttk.Frame(self.notebook, style="TFrame")
        balance_tab = ttk.Frame(self.notebook, style="TFrame")
        gait_tab = ttk.Frame(self.notebook, style="TFrame")
        pose_tab = ttk.Frame(self.notebook, style="TFrame")
        gazebo_tab = ttk.Frame(self.notebook, style="TFrame")

        self.notebook.add(monitor_tab, text="Giám sát")
        self.notebook.add(settings_tab, text="Cài đặt thông số")
        self.notebook.add(balance_tab, text="Balance")
        self.notebook.add(gait_tab, text="Gait")
        self.notebook.add(pose_tab, text="Tọa độ")
        self.notebook.add(gazebo_tab, text="Gazebo")
        self.notebook.bind("<<NotebookTabChanged>>", self.on_notebook_tab_changed)

        main = ttk.Frame(monitor_tab, padding=12)
        main.pack(fill=tk.BOTH, expand=True)

        # Thông tin đề tài và logo hai bên.
        self.build_header_with_logos(main)

        content = ttk.Frame(main)
        content.pack(fill=tk.BOTH, expand=True)

        # Khung camera bên trái.
        left = ttk.Frame(content, style="Panel.TFrame", padding=8)
        left.pack(side=tk.LEFT, fill=tk.BOTH, expand=True, padx=(0, 10))

        self.video_label = ttk.Label(left, background="#000000", anchor="center")
        self.video_label.pack(fill=tk.BOTH, expand=True)

        # Bảng điều khiển bên phải.
        right = ttk.Frame(content, style="Panel.TFrame", padding=16, width=1080)
        right.pack(side=tk.RIGHT, fill=tk.BOTH)
        right.pack_propagate(False)

        ttk.Label(right, text="UDP / PID", style="SubTitle.TLabel").pack(anchor="w")

        top_info = ttk.Frame(right, style="Panel.TFrame")
        top_info.pack(fill=tk.X, pady=(2, 5))

        self.info_pi_ip = ttk.Label(
            top_info,
            text=f"Pi IP: {RASPBERRY_IP}:{RASPBERRY_OFFSET_PORT}",
            style="Info.TLabel"
        )
        self.info_cam_port = ttk.Label(
            top_info,
            text=f"Cam UDP: {CAMERA_UDP_PORT}",
            style="Info.TLabel"
        )
        self.info_imu_port = ttk.Label(
            top_info,
            text=f"IMU UDP: {IMU_LISTEN_PORT}",
            style="Info.TLabel"
        )

        self.info_pi_ip.grid(row=0, column=0, sticky="w", padx=(0, 20))
        self.info_cam_port.grid(row=0, column=1, sticky="w", padx=(0, 20))
        self.info_imu_port.grid(row=0, column=2, sticky="w")

        self.info_udp = ttk.Label(right, text="UDP CAM: waiting...", style="Info.TLabel")
        self.info_imu = ttk.Label(right, text="UDP IMU: waiting...", style="Info.TLabel")
        self.info_gui_fps = ttk.Label(right, text="GUI FPS: 0.0", style="Info.TLabel")
        self.info_udp.pack(anchor="w", pady=1)
        self.info_imu.pack(anchor="w", pady=1)
        self.info_gui_fps.pack(anchor="w", pady=1)

        pid_box = ttk.Frame(right, style="Panel.TFrame")
        pid_box.pack(fill=tk.X, pady=(8, 8))

        self.btn_pid_on = ttk.Button(
            pid_box,
            text="BẬT BÁM NGƯỜI",
            style="Green.TButton",
            command=self.start_cam_pid
        )
        self.btn_pid_on.pack(side=tk.LEFT, fill=tk.X, expand=True, padx=(0, 6))

        self.btn_pid_off = ttk.Button(
            pid_box,
            text="TẮT BÁM NGƯỜI",
            style="Red.TButton",
            command=self.stop_cam_pid
        )
        self.btn_pid_off.pack(side=tk.LEFT, fill=tk.X, expand=True)

        self.pid_state_label = ttk.Label(right, text="PID cam: OFF", style="Info.TLabel")
        self.pid_state_label.pack(anchor="w", pady=(0, 5))

        # Cụm REC IMU hiển thị ở cả tab Giám sát và tab Balance.
        self.build_rec_controls(right)

        # Các nút điều khiển thủ công.
        manual_box = ttk.LabelFrame(right, text="Điều khiển robot từ GUI", padding=8)
        manual_box.pack(fill=tk.X, pady=(4, 8))

        # Hàng nút chọn tư thế.
        pose_row = ttk.Frame(manual_box, style="Panel.TFrame")
        pose_row.pack(fill=tk.X, pady=(0, 6))
        ttk.Button(pose_row, text="ĐỨNG", style="Blue.TButton", command=lambda: self.send_manual_cmd("STAND")).pack(side=tk.LEFT, fill=tk.X, expand=True, padx=3)
        ttk.Button(pose_row, text="NGỒI", style="Gray.TButton", command=lambda: self.send_manual_cmd("SIT")).pack(side=tk.LEFT, fill=tk.X, expand=True, padx=3)
        ttk.Button(pose_row, text="NẰM", style="Gray.TButton", command=lambda: self.send_manual_cmd("LIE")).pack(side=tk.LEFT, fill=tk.X, expand=True, padx=3)
        ttk.Button(pose_row, text="BẮT TAY", style="Blue.TButton", command=lambda: self.send_manual_cmd("SHAKE")).pack(side=tk.LEFT, fill=tk.X, expand=True, padx=3)

        # Hàng nút điều khiển di chuyển chính.
        move_grid = ttk.Frame(manual_box, style="Panel.TFrame")
        move_grid.pack(fill=tk.X)
        for c in range(5):
            move_grid.columnconfigure(c, weight=1)

        ttk.Button(move_grid, text="TIẾN", style="Green.TButton", command=lambda: self.send_manual_motion("FWD")).grid(row=0, column=1, sticky="ew", padx=3, pady=3)
        ttk.Button(move_grid, text="LÙI", style="Green.TButton", command=lambda: self.send_manual_motion("BWD")).grid(row=2, column=1, sticky="ew", padx=3, pady=3)
        ttk.Button(move_grid, text="TRÁI", style="Blue.TButton", command=lambda: self.send_manual_motion("LEFT")).grid(row=1, column=0, sticky="ew", padx=3, pady=3)
        ttk.Button(move_grid, text="PHẢI", style="Blue.TButton", command=lambda: self.send_manual_motion("RIGHT")).grid(row=1, column=2, sticky="ew", padx=3, pady=3)
        ttk.Button(move_grid, text="STOP", style="Red.TButton", command=self.send_manual_stop).grid(row=1, column=1, sticky="ew", padx=3, pady=3)
        ttk.Button(move_grid, text="SL", style="Blue.TButton", command=lambda: self.send_manual_motion("SL")).grid(row=1, column=3, sticky="ew", padx=3, pady=3)
        ttk.Button(move_grid, text="SR", style="Blue.TButton", command=lambda: self.send_manual_motion("SR")).grid(row=1, column=4, sticky="ew", padx=3, pady=3)

        # Hàng chỉnh chiều cao trục X; Pi chuyển lệnh về ESP mà không gửi STOP trước.
        height_row = ttk.Frame(manual_box, style="Panel.TFrame")
        height_row.pack(fill=tk.X, pady=(6, 0))
        ttk.Label(height_row, text="Chiều cao X:", style="Info.TLabel").pack(side=tk.LEFT, padx=(0, 8))
        ttk.Button(height_row, text="X+ / CAO+", style="CompactGreen.TButton", command=self.send_height_up).pack(side=tk.LEFT, fill=tk.X, expand=True, padx=3)
        ttk.Button(height_row, text="X- / CAO-", style="CompactBlue.TButton", command=self.send_height_down).pack(side=tk.LEFT, fill=tk.X, expand=True, padx=3)
        ttk.Button(height_row, text="X = -190", style="CompactGray.TButton", command=self.send_height_reset).pack(side=tk.LEFT, fill=tk.X, expand=True, padx=3)
        self.height_label = ttk.Label(height_row, text=f"X={self.height_x:.0f} mm", style="Info.TLabel")
        self.height_label.pack(side=tk.LEFT, padx=(10, 0))


        ttk.Separator(right).pack(fill=tk.X, pady=6)

        # Hiển thị giá trị IMU lớn.
        ttk.Label(right, text="IMU Roll / Pitch / Yaw", style="SubTitle.TLabel").pack(anchor="w")

        self.imu_value_label = ttk.Label(
            right,
            text="Roll: 0.00°    Pitch: 0.00°    Yaw: 0.00°",
            style="BigImu.TLabel",
            padding=8
        )
        self.imu_value_label.pack(fill=tk.X, pady=(2, 4))

        # Tab Giám sát không hiển thị đồ thị IMU.
        # IMU vẫn được nhận để hiển thị số và ghi CSV; có thể chọn file CSV để xem lại đồ thị.

        self.debug_label = ttk.Label(
            right,
            text="Last UDP: None",
            style="Debug.TLabel",
            wraplength=900,
            justify=tk.LEFT,
            padding=5
        )
        self.debug_label.pack(fill=tk.X, pady=(2, 3))

        self.box_debug_label = ttk.Label(
            right,
            text="BOX H: waiting...",
            style="Debug.TLabel",
            wraplength=900,
            justify=tk.LEFT,
            padding=5
        )
        self.box_debug_label.pack(fill=tk.X, pady=(0, 3))

        self.status_label = ttk.Label(
            right,
            text="Ready",
            style="Status.TLabel",
            wraplength=900
        )
        self.status_label.pack(anchor="w", fill=tk.X, pady=(2, 0))

        self.build_settings_tab(settings_tab)
        self.build_balance_tab(balance_tab)
        self.build_gait_tab(gait_tab)
        self.build_pose_tab(pose_tab)

        # Chạy luồng IK12 → JointTrajectory ẩn phía sau để Gazebo vẫn nhận lệnh.
        # Tab Gazebo chỉ hiển thị đồ thị so sánh IMU Gazebo và IMU thực tế.
        hidden_joint_frame = ttk.Frame(gazebo_tab, style="TFrame")
        self.joint_mapper_panel = JointMapperPanel(hidden_joint_frame)
        self.gazebo_imu_panel = GazeboImuComparePanel(gazebo_tab, self, self.joint_mapper_panel)
        self.apply_runtime_performance_settings()
        self.root.after(100, self.on_notebook_tab_changed)

        self.root.bind("<b>", lambda e: self.start_cam_pid())
        self.root.bind("<B>", lambda e: self.start_cam_pid())
        self.root.bind("<n>", lambda e: self.stop_cam_pid())
        self.root.bind("<N>", lambda e: self.stop_cam_pid())
        self.root.bind("<q>", lambda e: self.on_close())
        self.root.bind("<Q>", lambda e: self.on_close())
        self.root.bind("<Escape>", lambda e: self.end_fullscreen())
        self.root.bind("<F11>", lambda e: self.toggle_fullscreen())
        self.root.bind("<r>", lambda e: self.start_imu_record())
        self.root.bind("<R>", lambda e: self.start_imu_record())

        # Phím tắt điều khiển robot từ GUI.
        self.root.bind("<w>", lambda e: self.send_manual_motion("FWD"))
        self.root.bind("<W>", lambda e: self.send_manual_motion("FWD"))
        self.root.bind("<s>", lambda e: self.send_manual_motion("BWD"))
        self.root.bind("<S>", lambda e: self.send_manual_motion("BWD"))
        self.root.bind("<a>", lambda e: self.send_manual_motion("LEFT"))
        self.root.bind("<A>", lambda e: self.send_manual_motion("LEFT"))
        self.root.bind("<d>", lambda e: self.send_manual_motion("RIGHT"))
        self.root.bind("<D>", lambda e: self.send_manual_motion("RIGHT"))
        self.root.bind("<z>", lambda e: self.send_manual_motion("SL"))
        self.root.bind("<Z>", lambda e: self.send_manual_motion("SL"))
        self.root.bind("<x>", lambda e: self.send_manual_motion("SR"))
        self.root.bind("<X>", lambda e: self.send_manual_motion("SR"))
        self.root.bind("<Prior>", lambda e: self.send_height_up())      # PageUp
        self.root.bind("<Next>", lambda e: self.send_height_down())     # PageDown
        self.root.bind("<space>", lambda e: self.send_manual_stop())
        self.root.bind("<KeyPress-1>", lambda e: self.send_manual_cmd("STAND"))
        self.root.bind("<KeyPress-2>", lambda e: self.send_manual_cmd("SIT"))
        self.root.bind("<KeyPress-3>", lambda e: self.send_manual_cmd("LIE"))
        self.root.bind("<KeyPress-4>", lambda e: self.send_manual_cmd("SHAKE"))


    # ================== CHẾ ĐỘ ƯU TIÊN BALANCE ==================
    def get_current_tab_text(self):
        try:
            tab_id = self.notebook.select()
            if not tab_id:
                return ""
            return str(self.notebook.tab(tab_id, "text"))
        except Exception:
            return ""

    def is_balance_tab_active(self):
        return self.get_current_tab_text().strip().lower() == "balance"

    def on_notebook_tab_changed(self, event=None):
        if not bool(BALANCE_FOCUS_MODE_ENABLE):
            return
        tab_text = self.get_current_tab_text()
        self._balance_last_tab_text = tab_text
        if tab_text.strip().lower() == "balance":
            self.enter_balance_focus_mode()
        else:
            self.exit_balance_focus_mode()

    def enter_balance_focus_mode(self):
        if self.balance_focus_mode:
            return
        self.balance_focus_mode = True

        # 1) Dừng gửi gói camera PID và tạm dừng decode camera.
        self._balance_saved_send_camera_data = self.send_camera_data
        self.send_camera_data = False
        if bool(BALANCE_PAUSE_CAMERA):
            try:
                if self.udp_cam is not None:
                    self.udp_cam.set_paused(True)
            except Exception as e:
                print("[BALANCE FOCUS] pause camera error:", e)

        # 2) Tạm dừng publish sang Gazebo.
        if bool(BALANCE_PAUSE_GAZEBO_PUBLISH):
            try:
                if hasattr(self, "joint_mapper_panel") and self.joint_mapper_panel is not None:
                    self._balance_saved_gazebo_publish = bool(self.joint_mapper_panel.publish_enabled.get())
                    self.joint_mapper_panel.publish_enabled.set(False)
            except Exception as e:
                print("[BALANCE FOCUS] pause gazebo publish error:", e)

        # 3) Tạm dừng cập nhật bảng mapping ẩn.
        if bool(BALANCE_PAUSE_JOINT_TABLE_UI):
            try:
                if hasattr(self, "joint_mapper_panel") and self.joint_mapper_panel is not None:
                    self.joint_mapper_panel.set_ui_paused(True)
            except Exception as e:
                print("[BALANCE FOCUS] pause joint table error:", e)

        try:
            self.last_status_msg = "Balance focus ON: tạm dừng camera/Gazebo để giảm lag plot IMU"
            self.update_status()
        except Exception:
            pass
        try:
            if hasattr(self, "performance_status_label"):
                self.performance_status_label.config(
                    text="Balance focus ON: camera decode OFF | Gazebo publish OFF | Gazebo plot OFF | IMU/REC vẫn chạy"
                )
        except Exception:
            pass

    def exit_balance_focus_mode(self):
        if not self.balance_focus_mode:
            return
        self.balance_focus_mode = False

        # Khôi phục decode camera và trạng thái gửi camera như trước.
        self.send_camera_data = self._balance_saved_send_camera_data
        try:
            if self.udp_cam is not None:
                self.udp_cam.set_paused(False)
        except Exception as e:
            print("[BALANCE FOCUS] resume camera error:", e)

        # Khôi phục trạng thái publish Gazebo như trước khi vào tab Balance.
        try:
            if hasattr(self, "joint_mapper_panel") and self.joint_mapper_panel is not None:
                if self._balance_saved_gazebo_publish is not None:
                    self.joint_mapper_panel.publish_enabled.set(bool(self._balance_saved_gazebo_publish))
                self.joint_mapper_panel.set_ui_paused(False)
        except Exception as e:
            print("[BALANCE FOCUS] resume gazebo error:", e)

        try:
            self.apply_runtime_performance_settings()
            self.last_status_msg = "Balance focus OFF: đã khôi phục camera/Gazebo"
            self.update_status()
        except Exception:
            pass


    # ================== TAB BALANCE / SBAL ==================
    def build_rec_controls(self, parent):
        """Tạo cụm nút REC IMU dùng chung cho tab Giám sát và tab Balance."""
        rec_box = ttk.LabelFrame(parent, text="", padding=10)
        rec_box.pack(fill=tk.X, pady=(4, 10))

        rec_btn_row = ttk.Frame(rec_box, style="Panel.TFrame")
        rec_btn_row.pack(fill=tk.X)

        ttk.Button(
            rec_btn_row,
            text="CHỌN FOLDER",
            style="CompactGray.TButton",
            command=self.choose_rec_folder
        ).pack(side=tk.LEFT, fill=tk.X, expand=True, padx=(0, 5))

        ttk.Button(
            rec_btn_row,
            text="BẮT ĐẦU REC IMU+OFFSET",
            style="CompactGreen.TButton",
            command=self.start_imu_record
        ).pack(side=tk.LEFT, fill=tk.X, expand=True, padx=5)

        ttk.Button(
            rec_btn_row,
            text="DỪNG REC",
            style="CompactRed.TButton",
            command=self.stop_imu_record
        ).pack(side=tk.LEFT, fill=tk.X, expand=True, padx=5)

        ttk.Button(
            rec_btn_row,
            text="CHỌN FILE CSV ĐỂ PLOT",
            style="CompactBlue.TButton",
            command=self.choose_csv_and_plot
        ).pack(side=tk.LEFT, fill=tk.X, expand=True, padx=(5, 0))

        label = ttk.Label(
            rec_box,
            text=f"REC: OFF | Folder: {self.rec_folder}",
            style="Small.TLabel",
            wraplength=900
        )
        label.pack(anchor="w", fill=tk.X, pady=(6, 0))
        self.rec_status_labels.append(label)
        return rec_box

    def set_rec_status_text(self, text):
        for label in getattr(self, "rec_status_labels", []):
            try:
                label.config(text=text)
            except Exception:
                pass

    def build_balance_tab(self, parent):
        outer = ttk.Frame(parent, style="TFrame", padding=16)
        outer.pack(fill=tk.BOTH, expand=True)

        ttk.Label(outer, text="BALANCE SBAL - PID + SETPOINT + LIVE PLOT", style="Title.TLabel").pack(anchor="w", pady=(0, 10))

        body = ttk.Frame(outer, style="TFrame")
        body.pack(fill=tk.BOTH, expand=True)

        left = ttk.Frame(body, style="Panel.TFrame", padding=14)
        left.pack(side=tk.LEFT, fill=tk.Y, padx=(0, 12))

        cmd_box = ttk.LabelFrame(left, text="Lệnh balance", padding=10)
        cmd_box.pack(fill=tk.X, pady=(0, 10))
        ttk.Button(cmd_box, text="STAND", style="Blue.TButton", command=lambda: self.send_balance_command_sequence(["STAND"], "Balance gửi STAND")).grid(row=0, column=0, padx=5, pady=5, sticky="ew")
        ttk.Button(cmd_box, text="SBAL ON", style="Green.TButton", command=lambda: self.send_balance_command_sequence(["STAND", "SBAL_ON"], "Balance STAND + SBAL_ON")).grid(row=0, column=1, padx=5, pady=5, sticky="ew")
        ttk.Button(cmd_box, text="SBAL OFF", style="Red.TButton", command=lambda: self.send_balance_command_sequence(["SBAL_OFF"], "Balance SBAL_OFF")).grid(row=0, column=2, padx=5, pady=5, sticky="ew")
        ttk.Button(cmd_box, text="SHOWSBAL", style="Gray.TButton", command=lambda: self.send_balance_command_sequence(["SHOWSBAL"], "Balance SHOWSBAL")).grid(row=0, column=3, padx=5, pady=5, sticky="ew")
        for c in range(4):
            cmd_box.columnconfigure(c, weight=1)

        # Cụm REC IMU hiển thị ở cả tab Giám sát và tab Balance.
        self.build_rec_controls(left)

        pid_box = ttk.LabelFrame(left, text="Chỉnh PID SBAL", padding=10)
        pid_box.pack(fill=tk.X, pady=(0, 10))
        labels = ["Kp", "Ki", "Kd", "MaxX", "Deadband", "Hold", "IMax"]
        vars_ = [self.sbal_kp_var, self.sbal_ki_var, self.sbal_kd_var, self.sbal_maxx_var, self.sbal_deadband_var, self.sbal_hold_var, self.sbal_imax_var]
        for i, (lb, var) in enumerate(zip(labels, vars_)):
            ttk.Label(pid_box, text=lb, style="Info.TLabel").grid(row=0, column=i, padx=3, pady=(0, 4))
            ttk.Entry(pid_box, textvariable=var, width=8, font=("Consolas", 13)).grid(row=1, column=i, padx=3, pady=4)

        btnrow = ttk.Frame(pid_box, style="Panel.TFrame")
        btnrow.grid(row=2, column=0, columnspan=7, sticky="ew", pady=(8, 2))
        ttk.Button(btnrow, text="GỬI SET_SBAL", style="Green.TButton", command=self.send_sbal_pid).pack(side=tk.LEFT, fill=tk.X, expand=True, padx=3)
        ttk.Button(btnrow, text="GỬI IMax", style="Blue.TButton", command=self.send_sbal_imax).pack(side=tk.LEFT, fill=tk.X, expand=True, padx=3)
        ttk.Button(btnrow, text="Ki = 0", style="Gray.TButton", command=self.zero_sbal_ki).pack(side=tk.LEFT, fill=tk.X, expand=True, padx=3)

        # Chỉ sử dụng một bộ thông số PID mặc định, không dùng các preset nhẹ/vừa/mạnh.
        default_note = ttk.Label(
            pid_box,
            text="Mặc định: Kp=0.1 | Ki=1.5 | Kd=0.0 | MaxX=80 | Deadband=0.1 | Hold=0.25 | IMax=40",
            style="Small.TLabel"
        )
        default_note.grid(row=3, column=0, columnspan=7, sticky="w", pady=(8, 0))

        sp_box = ttk.LabelFrame(left, text="Setpoint Roll/Pitch - Joystick ±15°", padding=10)
        sp_box.pack(fill=tk.X, pady=(0, 10))

        self.sbal_joy_canvas = tk.Canvas(sp_box, width=self.sbal_joy_size, height=self.sbal_joy_size, bg="white", highlightthickness=1, highlightbackground="#94a3b8")
        self.sbal_joy_canvas.grid(row=0, column=0, rowspan=5, padx=(0, 12), pady=4)
        self.draw_sbal_joystick_base()
        self.sbal_joy_canvas.bind("<Button-1>", self.on_sbal_joystick_event)
        self.sbal_joy_canvas.bind("<B1-Motion>", self.on_sbal_joystick_event)
        self.sbal_joy_canvas.bind("<ButtonRelease-1>", lambda e: self.send_sbal_setpoint(log_cmd=True))

        ttk.Label(sp_box, text="Roll SP (deg)", style="Info.TLabel").grid(row=0, column=1, padx=5, pady=5, sticky="w")
        ttk.Label(sp_box, text="Pitch SP (deg)", style="Info.TLabel").grid(row=0, column=2, padx=5, pady=5, sticky="w")
        ttk.Entry(sp_box, width=12, textvariable=self.sbal_roll_sp_var, font=("Consolas", 14)).grid(row=1, column=1, padx=5, pady=5)
        ttk.Entry(sp_box, width=12, textvariable=self.sbal_pitch_sp_var, font=("Consolas", 14)).grid(row=1, column=2, padx=5, pady=5)
        ttk.Button(sp_box, text="GỬI SET_SBAL_SP", style="Green.TButton", command=self.send_sbal_setpoint).grid(row=1, column=3, padx=5, pady=5, sticky="ew")
        ttk.Button(sp_box, text="SP = 0", style="Gray.TButton", command=self.zero_sbal_setpoint).grid(row=2, column=3, padx=5, pady=5, sticky="ew")

        self.sbal_sp_value_label = ttk.Label(sp_box, text="Roll SP = 0.00° | Pitch SP = 0.00°", style="BigImu.TLabel", padding=6)
        self.sbal_sp_value_label.grid(row=3, column=1, columnspan=3, sticky="ew", padx=5, pady=(8, 0))
        self.update_sbal_joystick_knob_from_sp()

        right = ttk.Frame(body, style="Panel.TFrame", padding=14)
        right.pack(side=tk.RIGHT, fill=tk.BOTH, expand=True)
        ttk.Label(right, text="LIVE Roll/Pitch thực tế + setpoint", style="SubTitle.TLabel").pack(anchor="w")
        self.sbal_status_label = ttk.Label(right, text="SBAL tab ready", style="Info.TLabel")
        self.sbal_status_label.pack(anchor="w", pady=(0, 6))

        self.sbal_imu_hz_label = ttk.Label(
            right,
            text="Tần số IMU ESP: RX 0.0 Hz | Plot Balance 0.0 Hz | RAW không lọc | seq=0",
            style="BigImu.TLabel",
            padding=6
        )
        self.sbal_imu_hz_label.pack(anchor="w", fill=tk.X, pady=(0, 8))

        self.sbal_fig = Figure(figsize=(10.5, 6.2), dpi=100, facecolor="#ffffff")
        self.sbal_ax = self.sbal_fig.add_subplot(111)
        self.sbal_line_roll, = self.sbal_ax.plot([], [], label="Roll thực tế", color="tab:blue", linewidth=2.0)
        self.sbal_line_pitch, = self.sbal_ax.plot([], [], label="Pitch thực tế", color="tab:orange", linewidth=2.0)
        self.sbal_roll_sp_line = self.sbal_ax.axhline(0.0, color="tab:blue", linestyle="--", linewidth=1.4, label="Roll SP")
        self.sbal_pitch_sp_line = self.sbal_ax.axhline(0.0, color="tab:orange", linestyle="--", linewidth=1.4, label="Pitch SP")
        self.sbal_ax.set_title("LIVE Roll / Pitch SBAL", fontsize=15, fontweight="bold")
        self.sbal_ax.set_xlabel("Time (s)")
        self.sbal_ax.set_ylabel("Angle (deg)")
        self.sbal_ax.set_ylim(-25, 25)
        self.sbal_ax.grid(True, color="#cbd5e1", linewidth=0.8)
        self.sbal_ax.legend(loc="upper right")
        self.sbal_canvas = FigureCanvasTkAgg(self.sbal_fig, master=right)
        self.sbal_canvas.get_tk_widget().pack(fill=tk.BOTH, expand=True)
        self.update_sbal_live_plot()

    def send_balance_command_sequence(self, commands, msg="Balance command sent"):
        self.cam_pid_enabled = False

        seq = ["CAMGAIT_OFF"] + [str(c).strip().upper() for c in commands]
        self.send_command_sequence_to_pi(seq, msg)

    def clamp_float(self, value, lo, hi):
        return max(lo, min(hi, value))

    def draw_sbal_joystick_base(self):
        c = self.sbal_joy_center
        r = self.sbal_joy_radius
        self.sbal_joy_canvas.create_oval(c-r, c-r, c+r, c+r, outline="#334155", width=2)
        self.sbal_joy_canvas.create_line(c-r, c, c+r, c, fill="#cbd5e1", width=1)
        self.sbal_joy_canvas.create_line(c, c-r, c, c+r, fill="#cbd5e1", width=1)
        self.sbal_joy_canvas.create_text(c, 16, text="-Pitch", fill="#64748b", font=("Arial", 9))
        self.sbal_joy_canvas.create_text(c, self.sbal_joy_size-16, text="+Pitch", fill="#64748b", font=("Arial", 9))
        self.sbal_joy_canvas.create_text(32, c, text="-Roll", fill="#64748b", font=("Arial", 9))
        self.sbal_joy_canvas.create_text(self.sbal_joy_size-32, c, text="+Roll", fill="#64748b", font=("Arial", 9))
        rr = self.sbal_joy_knob_radius
        self.sbal_joy_knob = self.sbal_joy_canvas.create_oval(c-rr, c-rr, c+rr, c+rr, fill="#ef4444", outline="#111827", width=1)

    def sbal_joystick_pos_to_sp(self, x, y):
        dx = x - self.sbal_joy_center
        dy = y - self.sbal_joy_center
        dist = math.sqrt(dx*dx + dy*dy)
        if dist > self.sbal_joy_radius:
            k = self.sbal_joy_radius / max(dist, 1e-6)
            dx *= k
            dy *= k
        roll_sp = (dx / self.sbal_joy_radius) * self.sbal_sp_limit_deg
        pitch_sp = (dy / self.sbal_joy_radius) * self.sbal_sp_limit_deg
        return self.clamp_float(roll_sp, -self.sbal_sp_limit_deg, self.sbal_sp_limit_deg), self.clamp_float(pitch_sp, -self.sbal_sp_limit_deg, self.sbal_sp_limit_deg)

    def sbal_sp_to_joystick_pos(self, roll_sp, pitch_sp):
        roll_sp = self.clamp_float(roll_sp, -self.sbal_sp_limit_deg, self.sbal_sp_limit_deg)
        pitch_sp = self.clamp_float(pitch_sp, -self.sbal_sp_limit_deg, self.sbal_sp_limit_deg)
        x = self.sbal_joy_center + (roll_sp / self.sbal_sp_limit_deg) * self.sbal_joy_radius
        y = self.sbal_joy_center + (pitch_sp / self.sbal_sp_limit_deg) * self.sbal_joy_radius
        return x, y

    def set_sbal_joystick_knob_xy(self, x, y):
        rr = self.sbal_joy_knob_radius
        self.sbal_joy_canvas.coords(self.sbal_joy_knob, x-rr, y-rr, x+rr, y+rr)

    def get_sbal_setpoints(self):
        try:
            roll_sp = float(self.sbal_roll_sp_var.get())
        except Exception:
            roll_sp = 0.0
        try:
            pitch_sp = float(self.sbal_pitch_sp_var.get())
        except Exception:
            pitch_sp = 0.0
        roll_sp = self.clamp_float(roll_sp, -self.sbal_sp_limit_deg, self.sbal_sp_limit_deg)
        pitch_sp = self.clamp_float(pitch_sp, -self.sbal_sp_limit_deg, self.sbal_sp_limit_deg)
        return roll_sp, pitch_sp

    def update_sbal_sp_value_label(self):
        if not hasattr(self, "sbal_sp_value_label"):
            return
        roll_sp, pitch_sp = self.get_sbal_setpoints()
        self.sbal_sp_value_label.config(text=f"Roll SP = {roll_sp:.2f}° | Pitch SP = {pitch_sp:.2f}°")

    def update_sbal_joystick_knob_from_sp(self):
        if not hasattr(self, "sbal_joy_canvas"):
            return
        roll_sp, pitch_sp = self.get_sbal_setpoints()
        x, y = self.sbal_sp_to_joystick_pos(roll_sp, pitch_sp)
        self.set_sbal_joystick_knob_xy(x, y)
        self.update_sbal_sp_value_label()

    def on_sbal_joystick_event(self, event):
        roll_sp, pitch_sp = self.sbal_joystick_pos_to_sp(event.x, event.y)
        self.sbal_roll_sp_var.set(f"{roll_sp:.2f}")
        self.sbal_pitch_sp_var.set(f"{pitch_sp:.2f}")
        x, y = self.sbal_sp_to_joystick_pos(roll_sp, pitch_sp)
        self.set_sbal_joystick_knob_xy(x, y)
        self.update_sbal_sp_value_label()
        now = time.time()
        if now - self.sbal_last_sp_send_time >= self.sbal_sp_send_interval:
            self.sbal_last_sp_send_time = now
            self.send_sbal_setpoint(log_cmd=False)

    def send_sbal_pid(self):
        try:
            kp = float(self.sbal_kp_var.get())
            ki = float(self.sbal_ki_var.get())
            kd = float(self.sbal_kd_var.get())
            maxx = float(self.sbal_maxx_var.get())
            deadband = float(self.sbal_deadband_var.get())
            hold = float(self.sbal_hold_var.get())
        except ValueError:
            messagebox.showerror("Lỗi nhập PID", "Kp Ki Kd MaxX Deadband Hold phải là số")
            return
        self.send_balance_command_sequence([f"SET_SBAL {kp:.4f} {ki:.4f} {kd:.4f} {maxx:.2f} {deadband:.2f} {hold:.2f}"], "Đã gửi SET_SBAL")

    def send_sbal_imax(self):
        try:
            imax = float(self.sbal_imax_var.get())
        except ValueError:
            messagebox.showerror("Lỗi nhập IMax", "IMax phải là số")
            return
        self.send_balance_command_sequence([f"SET_SBAL_IMAX {imax:.2f}"], "Đã gửi SET_SBAL_IMAX")

    def set_sbal_light(self):
        self.sbal_kp_var.set("0.5"); self.sbal_ki_var.set("0.0"); self.sbal_kd_var.set("0.25")
        self.sbal_maxx_var.set("60"); self.sbal_deadband_var.set("0.8"); self.sbal_hold_var.set("0.25"); self.sbal_imax_var.set("40")
        self.send_sbal_pid(); self.send_sbal_imax()

    def set_sbal_medium(self):
        self.sbal_kp_var.set("0.5"); self.sbal_ki_var.set("2.0"); self.sbal_kd_var.set("0.4")
        self.sbal_maxx_var.set("80"); self.sbal_deadband_var.set("0.5"); self.sbal_hold_var.set("0.25"); self.sbal_imax_var.set("40")
        self.send_sbal_pid(); self.send_sbal_imax()

    def set_sbal_strong(self):
        self.sbal_kp_var.set("0.8"); self.sbal_ki_var.set("2.5"); self.sbal_kd_var.set("0.5")
        self.sbal_maxx_var.set("80"); self.sbal_deadband_var.set("0.5"); self.sbal_hold_var.set("0.25"); self.sbal_imax_var.set("40")
        self.send_sbal_pid(); self.send_sbal_imax()

    def zero_sbal_ki(self):
        self.sbal_ki_var.set("0.0")
        self.send_sbal_pid()

    def send_sbal_setpoint(self, log_cmd=True):
        roll_sp, pitch_sp = self.get_sbal_setpoints()
        self.sbal_roll_sp_var.set(f"{roll_sp:.2f}")
        self.sbal_pitch_sp_var.set(f"{pitch_sp:.2f}")
        self.update_sbal_joystick_knob_from_sp()

        # Quy ước joystick trên GUI:
        #   - Ngang trái/phải  -> Roll SP.
        #   - Trên/dưới       -> Pitch SP.
        # ESP đang hiểu SET_SBAL_SP theo thứ tự Pitch, Roll,
        # nên cần gửi pitch_sp trước để thao tác lên/xuống điều khiển đúng Pitch.
        if SBAL_SP_SEND_ORDER == "PITCH_ROLL":
            cmd = f"SET_SBAL_SP {pitch_sp:.3f} {roll_sp:.3f}"
        else:
            cmd = f"SET_SBAL_SP {roll_sp:.3f} {pitch_sp:.3f}"

        self.send_balance_command_sequence([cmd], "Đã gửi SET_SBAL_SP")

    def zero_sbal_setpoint(self):
        self.sbal_roll_sp_var.set("0")
        self.sbal_pitch_sp_var.set("0")
        self.update_sbal_joystick_knob_from_sp()
        self.send_balance_command_sequence(["SBAL_SP_ZERO"], "Đã gửi SBAL_SP_ZERO")

    def reset_balance_plot_filter(self):
        # GUI không lọc dữ liệu; hàm này được giữ lại để tương thích với code cũ.
        self.sbal_plot_filter_ready = False
        self.sbal_plot_roll_f = 0.0
        self.sbal_plot_pitch_f = 0.0

    def filter_balance_plot_sample(self, raw_roll, raw_pitch):
        # ESP đã lọc IMU, nên đồ thị Balance vẽ trực tiếp dữ liệu raw nhận được.
        # File REC CSV vẫn lấy dữ liệu raw từ buffer như trước.
        return float(raw_roll), float(raw_pitch)

    def update_sbal_live_plot(self):
        if not self.running:
            return

        # Chỉ cập nhật đồ thị Balance khi tab Balance đang được mở.
        # Khi ở tab khác, không vẽ canvas ẩn để giảm tải cho mainloop.
        if hasattr(self, "notebook") and not self.is_balance_tab_active():
            self.root.after(250, self.update_sbal_live_plot)
            return

        roll = pitch = yaw = 0.0
        t_last = 0.0
        imu_rx_hz = 0.0
        latest_seq = self.sbal_plot_last_seq
        added_samples = 0

        if self.udp_imu is not None:
            # Chỉ lấy mẫu IMU mới nhất để hiển thị live.
            # Không lấy toàn bộ buffer để tránh GUI vẽ dồn quá nhiều điểm trong một lần cập nhật,
            # vì điều đó có thể tạo cảm giác bị giật dù ESP/Serial vẫn đang chạy mượt.
            latest_seq, t_last, roll, pitch, yaw, imu_rx_hz = self.udp_imu.get_latest_sample()

            if t_last > 0 and latest_seq > self.sbal_plot_last_seq:
                t = t_last - self.sbal_plot_t0
                if t < 0:
                    t = time.time() - self.sbal_plot_t0

                # GUI không lọc và không chặn spike; ESP đã xử lý dữ liệu trước khi gửi.
                self.sbal_plot_t.append(t)
                self.sbal_plot_roll.append(float(roll))
                self.sbal_plot_pitch.append(float(pitch))
                self.sbal_plot_last_seq = int(latest_seq)
                added_samples = 1

        self.sbal_plot_count_n += added_samples
        now = time.time()
        dt_hz = now - self.sbal_plot_count_t0
        if dt_hz >= 1.0:
            self.sbal_plot_hz = self.sbal_plot_count_n / dt_hz
            self.sbal_plot_count_n = 0
            self.sbal_plot_count_t0 = now

        imu_age = now - t_last if t_last > 0 else 999.0
        imu_state = "OK" if imu_age < 2.0 else "WAIT"

        if hasattr(self, "sbal_imu_hz_label"):
            self.sbal_imu_hz_label.config(
                text=(
                    f"Tần số IMU ESP: RX {imu_rx_hz:.1f} Hz | "
                    f"Plot Balance {self.sbal_plot_hz:.1f} Hz | "
                    f"RAW không lọc | seq={self.sbal_plot_last_seq} | {imu_state} | FOCUS={'ON' if self.balance_focus_mode else 'OFF'}"
                )
            )

        if hasattr(self, "sbal_line_roll"):
            xs = list(self.sbal_plot_t)
            self.sbal_line_roll.set_data(xs, list(self.sbal_plot_roll))
            self.sbal_line_pitch.set_data(xs, list(self.sbal_plot_pitch))

            roll_sp, pitch_sp = self.get_sbal_setpoints()
            self.sbal_roll_sp_line.set_ydata([roll_sp, roll_sp])
            self.sbal_pitch_sp_line.set_ydata([pitch_sp, pitch_sp])

            if len(xs) >= 2:
                self.sbal_ax.set_xlim(max(0, xs[-1] - self.sbal_plot_window_sec), xs[-1] + 0.5)

            if bool(BALANCE_PLOT_FIXED_Y):
                self.sbal_ax.set_ylim(ROLL_YLIM[0], ROLL_YLIM[1])
            else:
                all_y = list(self.sbal_plot_roll) + list(self.sbal_plot_pitch) + [
                    roll_sp, pitch_sp, -self.sbal_sp_limit_deg, self.sbal_sp_limit_deg
                ]
                if all_y:
                    ymin, ymax = min(all_y), max(all_y)
                    if abs(ymax-ymin) < 1:
                        ymin -= 1
                        ymax += 1
                    margin = max(2, (ymax-ymin)*0.15)
                    self.sbal_ax.set_ylim(ymin-margin, ymax+margin)

            if t_last > 0:
                self.sbal_status_label.config(
                    text=(
                        f"IMU thực tế | Roll={roll:+.2f}° Pitch={pitch:+.2f}° Yaw={yaw:+.2f}° | "
                        f"SP Roll={roll_sp:+.2f}° Pitch={pitch_sp:+.2f}° | "
                        f"RX={imu_rx_hz:.1f}Hz Plot={self.sbal_plot_hz:.1f}Hz | RAW không lọc | FOCUS={'ON' if self.balance_focus_mode else 'OFF'}"
                    )
                )
            else:
                self.sbal_status_label.config(
                    text=(
                        f"IMU thực tế: waiting... | RX={imu_rx_hz:.1f}Hz "
                        f"Plot={self.sbal_plot_hz:.1f}Hz"
                    )
                )

            # Chỉ vẽ lại khi có mẫu mới để giảm tải CPU và hạn chế lag do Matplotlib.
            if added_samples > 0:
                self.sbal_canvas.draw_idle()

        self.root.after(BALANCE_PLOT_UPDATE_MS, self.update_sbal_live_plot)

    def update_datetime_label(self):
        try:
            now_txt = datetime.now().strftime("%d/%m/%Y  %H:%M:%S")
            if hasattr(self, "datetime_label"):
                self.datetime_label.config(text=now_txt)
                self.datetime_label.lift()
            if getattr(self, "running", True):
                self.root.after(1000, self.update_datetime_label)
        except Exception:
            pass

    # ================== TAB CÀI ĐẶT ==================
    def load_saved_config(self):
        if not os.path.exists(CONFIG_PATH):
            return
        try:
            with open(CONFIG_PATH, "r", encoding="utf-8") as f:
                data = json.load(f)
            self.apply_config_dict(data, recreate_pose=False, update_widgets=False, show_message=False)
            print(f"[CONFIG] Loaded: {CONFIG_PATH}")
        except Exception as e:
            print("[CONFIG] Loi load config:", e)


    # ================== TAB TỌA ĐỘ POSE ==================
    # ================== TAB TINH CHỈNH GAIT ==================
    def init_gait_config_vars(self):
        self.gait_vars = {}
        for mode in GAIT_MODES:
            defaults = GAIT_DEFAULTS[mode]
            self.gait_vars[mode] = {
                "hStep": tk.StringVar(value=f"{defaults['hStep']:.1f}"),
                "tCycle": tk.StringVar(value=f"{defaults['tCycle']:.2f}"),
                "phase": tk.StringVar(value=f"{defaults['phase']:.2f}"),
                "swing": tk.StringVar(value=f"{defaults['swing']:.2f}"),
            }
        self.load_gait_config_from_file(silent=True)

    def _safe_float_var(self, var, default, lo=None, hi=None):
        try:
            v = float(var.get())
        except Exception:
            v = float(default)
        if lo is not None:
            v = max(float(lo), v)
        if hi is not None:
            v = min(float(hi), v)
        return v

    def _get_gait_values(self, mode):
        defaults = GAIT_DEFAULTS[mode]
        gv = self.gait_vars[mode]
        h = self._safe_float_var(gv["hStep"], defaults["hStep"], -200.0, 200.0)
        t = self._safe_float_var(gv["tCycle"], defaults["tCycle"], 0.05, 10.0)
        phase = self._safe_float_var(gv["phase"], defaults["phase"], -100.0, 100.0)
        phase = phase - math.floor(phase)
        swing = self._safe_float_var(gv["swing"], defaults["swing"], 0.05, 0.49)
        gv["hStep"].set(f"{h:.2f}")
        gv["tCycle"].set(f"{t:.3f}")
        gv["phase"].set(f"{phase:.3f}")
        gv["swing"].set(f"{swing:.3f}")
        return h, t, phase, swing

    def build_gait_tab(self, parent):
        outer = ttk.Frame(parent, style="TFrame", padding=16)
        outer.pack(fill=tk.BOTH, expand=True)

        ttk.Label(outer, text="CHỈNH THÔNG SỐ GAIT DI CHUYỂN", style="Title.TLabel").pack(anchor="w", pady=(0, 10))


        table = ttk.Frame(outer, style="Panel.TFrame", padding=12)
        table.pack(fill=tk.X, pady=(0, 10))

        headers = ["Gait", "hStep", "tCycle (s)", "Phase", "Swing ratio", "Gửi", "Chạy thử"]
        for c, text in enumerate(headers):
            ttk.Label(table, text=text, style="SubTitle.TLabel").grid(row=0, column=c, padx=6, pady=(0, 8), sticky="w")
            table.columnconfigure(c, weight=1 if c in (1, 2, 3, 4) else 0)

        mode_labels = {
            "FWD": "FWD - Tiến",
            "BWD": "BWD - Lùi",
            "LEFT": "LEFT - Xoay trái",
            "RIGHT": "RIGHT - Xoay phải",
            "SL": "SL - Đi ngang trái",
            "SR": "SR - Đi ngang phải",
        }

        for r, mode in enumerate(GAIT_MODES, start=1):
            ttk.Label(table, text=mode_labels.get(mode, mode), style="Info.TLabel").grid(row=r, column=0, padx=6, pady=5, sticky="w")
            ttk.Entry(table, textvariable=self.gait_vars[mode]["hStep"], width=10, font=("Consolas", 13)).grid(row=r, column=1, padx=6, pady=5, sticky="ew")
            ttk.Entry(table, textvariable=self.gait_vars[mode]["tCycle"], width=10, font=("Consolas", 13)).grid(row=r, column=2, padx=6, pady=5, sticky="ew")
            ttk.Entry(table, textvariable=self.gait_vars[mode]["phase"], width=10, font=("Consolas", 13)).grid(row=r, column=3, padx=6, pady=5, sticky="ew")
            ttk.Entry(table, textvariable=self.gait_vars[mode]["swing"], width=10, font=("Consolas", 13)).grid(row=r, column=4, padx=6, pady=5, sticky="ew")
            ttk.Button(table, text="Gửi", style="CompactGreen.TButton", command=lambda m=mode: self.send_single_gait_config(m)).grid(row=r, column=5, padx=6, pady=5, sticky="ew")
            ttk.Button(table, text="Test", style="CompactBlue.TButton", command=lambda m=mode: self.test_gait_mode(m)).grid(row=r, column=6, padx=6, pady=5, sticky="ew")

        btn_bar = ttk.Frame(outer, style="Panel.TFrame", padding=12)
        btn_bar.pack(fill=tk.X, pady=(0, 10))
        ttk.Button(btn_bar, text="GỬI TẤT CẢ GAIT", style="Green.TButton", command=self.send_all_gait_configs).pack(side=tk.LEFT, padx=(0, 8))
        ttk.Button(btn_bar, text="LƯU FILE GUI", style="Blue.TButton", command=self.save_gait_config_to_file).pack(side=tk.LEFT, padx=(0, 8))
        ttk.Button(btn_bar, text="LOAD FILE GUI", style="Gray.TButton", command=lambda: self.load_gait_config_from_file(silent=False)).pack(side=tk.LEFT, padx=(0, 8))
        ttk.Button(btn_bar, text="RESET GUI DEFAULT", style="Gray.TButton", command=self.reset_gait_config_vars).pack(side=tk.LEFT, padx=(0, 8))
        ttk.Button(btn_bar, text="RESET ESP GAITS", style="Red.TButton", command=self.send_reset_gaits_to_esp).pack(side=tk.LEFT, padx=(0, 8))
        ttk.Button(btn_bar, text="SHOW ESP GAITS", style="Gray.TButton", command=lambda: self.send_udp_to_pi("SHOW_GAITS")).pack(side=tk.LEFT, padx=(0, 8))
        ttk.Button(btn_bar, text="STOP", style="Red.TButton", command=self.send_manual_stop).pack(side=tk.RIGHT, padx=(8, 0))

        self.gait_status_label = ttk.Label(outer, text="Gait tab ready", style="Status.TLabel", padding=8)
        self.gait_status_label.pack(fill=tk.X, pady=(0, 10))

        guide = ttk.LabelFrame(outer, text="Lệnh ESP nhận được", padding=10)
        guide.pack(fill=tk.X)
        txt = (
            "SET_GAIT FWD 100 0.70 0.50 0.35\n"
            "SET_GAIT_HSTEP FWD 90\n"
            "SET_GAIT_TCYCLE SL 0.60\n"
            "SET_GAIT_PHASE RIGHT 0.50\n"
            "SET_GAIT_SWING BWD 0.32\n"
            "SHOW_GAITS / RESET_GAITS"
        )
        ttk.Label(guide, text=txt, style="Info.TLabel", justify=tk.LEFT).pack(anchor="w")

    def send_single_gait_config(self, mode):
        mode = str(mode).strip().upper()
        if mode not in GAIT_MODES:
            return False
        h, t, phase, swing = self._get_gait_values(mode)
        cmd = f"SET_GAIT {mode} {h:.3f} {t:.3f} {phase:.3f} {swing:.3f}"
        ok = self.send_udp_to_pi(cmd)
        if ok:
            self.last_status_msg = f"Đã gửi {cmd}"
            if self.gait_status_label:
                self.gait_status_label.config(text=self.last_status_msg)
            self.update_status()
        return ok

    def send_all_gait_configs(self):
        cmds = []
        for mode in GAIT_MODES:
            h, t, phase, swing = self._get_gait_values(mode)
            cmds.append(f"SET_GAIT {mode} {h:.3f} {t:.3f} {phase:.3f} {swing:.3f}")
        cmds.append("SHOW_GAITS")
        self.send_command_sequence_to_pi(cmds, "Đã gửi toàn bộ cấu hình gait")
        if self.gait_status_label:
            self.gait_status_label.config(text="Đã gửi toàn bộ cấu hình gait xuống ESP")

    def test_gait_mode(self, mode):
        mode = str(mode).strip().upper()
        self.send_single_gait_config(mode)
        self.cam_pid_enabled = False
        # Tắt CAMGAIT để kiểm tra gait thủ công.
        self.send_command_sequence_to_pi(["CAMGAIT_OFF", mode], f"Test gait {mode}")

    def reset_gait_config_vars(self):
        for mode in GAIT_MODES:
            for key, value in GAIT_DEFAULTS[mode].items():
                self.gait_vars[mode][key].set(f"{float(value):.3f}" if key != "hStep" else f"{float(value):.2f}")
        if self.gait_status_label:
            self.gait_status_label.config(text="Đã reset giá trị trên GUI về mặc định")

    def send_reset_gaits_to_esp(self):
        self.reset_gait_config_vars()
        self.send_command_sequence_to_pi(["RESET_GAITS", "SHOW_GAITS"], "Đã reset gait trong ESP")
        if self.gait_status_label:
            self.gait_status_label.config(text="Đã gửi RESET_GAITS xuống ESP")

    def save_gait_config_to_file(self):
        data = {}
        for mode in GAIT_MODES:
            h, t, phase, swing = self._get_gait_values(mode)
            data[mode] = {"hStep": h, "tCycle": t, "phase": phase, "swing": swing}
        try:
            with open(GAIT_CONFIG_PATH, "w", encoding="utf-8") as f:
                json.dump(data, f, ensure_ascii=False, indent=2)
            if self.gait_status_label:
                self.gait_status_label.config(text=f"Đã lưu gait config: {GAIT_CONFIG_PATH}")
            messagebox.showinfo("Lưu gait", f"Đã lưu:\n{GAIT_CONFIG_PATH}")
        except Exception as e:
            messagebox.showerror("Lỗi lưu gait", str(e))

    def load_gait_config_from_file(self, silent=False):
        if not os.path.exists(GAIT_CONFIG_PATH):
            return
        try:
            with open(GAIT_CONFIG_PATH, "r", encoding="utf-8") as f:
                data = json.load(f)
            for mode in GAIT_MODES:
                if mode not in data:
                    continue
                for key in ("hStep", "tCycle", "phase", "swing"):
                    if key in data[mode]:
                        self.gait_vars[mode][key].set(str(data[mode][key]))
            if not silent:
                if self.gait_status_label:
                    self.gait_status_label.config(text=f"Đã load gait config: {GAIT_CONFIG_PATH}")
                messagebox.showinfo("Load gait", f"Đã load:\n{GAIT_CONFIG_PATH}")
        except Exception as e:
            if not silent:
                messagebox.showerror("Lỗi load gait", str(e))

    def build_pose_tab(self, parent):
        outer = ttk.Frame(parent, padding=10, style="TFrame")
        outer.pack(fill="both", expand=True)

        title_row = ttk.Frame(outer, style="TFrame")
        title_row.pack(fill="x", pady=(0, 8))
        ttk.Label(title_row, text="Cài đặt tọa độ các pose / tâm gait trong ESP", style="Title.TLabel").pack(side=tk.LEFT)
        self.pose_status_label = ttk.Label(title_row, text="Chưa gửi", style="Info.TLabel")
        self.pose_status_label.pack(side=tk.RIGHT)


        btn_bar = ttk.Frame(outer, style="TFrame")
        btn_bar.pack(fill="x", pady=(0, 8))
        ttk.Button(btn_bar, text="GỬI TẤT CẢ POSE", style="Green.TButton", command=self.send_all_pose_coords).pack(side=tk.LEFT, padx=(0, 8))
        ttk.Button(btn_bar, text="LƯU THÔNG SỐ", style="Blue.TButton", command=self.save_pose_coords_to_file).pack(side=tk.LEFT, padx=(0, 8))
        ttk.Button(btn_bar, text="LOAD THÔNG SỐ", style="Gray.TButton", command=self.load_pose_coords_from_file).pack(side=tk.LEFT, padx=(0, 8))
        ttk.Button(btn_bar, text="MẶC ĐỊNH", style="Orange.TButton", command=self.reset_pose_vars_default).pack(side=tk.LEFT, padx=(0, 8))
        ttk.Button(btn_bar, text="GỬI RESET_POSES ESP", style="Red.TButton", command=lambda: self.send_udp_to_pi("RESET_POSES")).pack(side=tk.LEFT, padx=(0, 8))
        ttk.Button(btn_bar, text="ĐỌC POSE TỪ ESP", style="Gray.TButton", command=lambda: self.send_udp_to_pi("SHOWPOSES")).pack(side=tk.LEFT, padx=(0, 8))

        canvas = tk.Canvas(outer, bg="#f8fafc", highlightthickness=0)
        scrollbar = ttk.Scrollbar(outer, orient="vertical", command=canvas.yview)
        content = ttk.Frame(canvas, style="TFrame")
        content.bind("<Configure>", lambda e: canvas.configure(scrollregion=canvas.bbox("all")))
        canvas.create_window((0, 0), window=content, anchor="nw")
        canvas.configure(yscrollcommand=scrollbar.set)
        canvas.pack(side="left", fill="both", expand=True)
        scrollbar.pack(side="right", fill="y")

        header = ttk.Frame(content, style="TFrame")
        header.pack(fill="x", pady=(0, 4))
        ttk.Label(header, text="Pose", width=9, style="Info.TLabel").grid(row=0, column=0, padx=3)
        col = 1
        for leg in POSE_LEGS:
            for axis in POSE_AXES:
                ttk.Label(header, text=f"{leg}_{axis}", width=8, style="Info.TLabel").grid(row=0, column=col, padx=2)
                col += 1
        ttk.Label(header, text="Thao tác", width=28, style="Info.TLabel").grid(row=0, column=col, padx=3)
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
